256-Foundation/emberone00-pcb/(threads)

Thread 4 (2024-11-18):

Release validated Ember One design

econoalchemist, 2024-11-18:
# Ember One

## Scope:
One Project Manager position and up to two engineer positions to fulfill the mission of The 256 Foundation, “ Make Bitcoin mining free and open”. This grant proposal aims to secure funding for:
- A project manager to oversee and ensure mission adherence, timeliness, and execution.
Up to two engineers to develop the Ember One hashboard.
-  Ember One technical details: a modular ~100W 2-4 Terahash open-source Bitcoin miner hashboard built with the Bitmain S19 J-Pro series ASIC chips including hardware component selection, PCB design, and thermal design.
- Supporting documentation with hashboard interface specification.
- This project is fully open-source GPL licensed.
- Excluded from this proposal are the firmware architecture & implementation, enclosure design, manufacturing support, sales, distribution, marketing, and customer technical support.

In summary, the Ember One grant delivers an open-source, discrete, and customizable ~100 Watt Bitcoin miner hashboard in six months with a project manager and up to two engineers. This project will be a springboard for a complete mining system built with ASIC chips from other manufacturers. The open design makes integrating it in a variety of ways possible. The small but mighty platform provides the essential tools for broad open development. Remaining anonymous while using Bitcoin's public blockchain is a crucial aspect to ensuring the potential for financial freedom; and Bitcoin mining is arguably the best way to acquire bitcoin for these ends. Not only does the Ember One equip users with a powerful tool for financial freedom but it also takes direct aim at altering the centralized and closed-source trajectory that the Bitcoin mining ecosystem has taken.

## Deliverables:
The deliverables from this grant are the successful execution of the project more so than tangible goods. Successful execution of this grant project means the delivery of a validated design for a modular ~100W hashboard is produced within the allotted timeline and for the available budget, resulting in an open-source project that aligns with The 256 Foundation mission and benefits the public at large.

## Timeline:
The timeline for this grant proposal is six months with the opportunity to extend the grant at the conclusion of each six month period, pending negotiations. This grant officially started November 1, 2024 and will conclude on April 30, 2025.

## Materials:
Materials for this project’s prototype are included in the budget. Potential materials for the project may include but are not limited to ASIC chips, miscellaneous components, and various tools or software.

## Team Members:
This proposal is for one project manager and up to two engineers.

## Budget:
For security reasons, exact dollar amounts are kept confidential. This project budget covers fair-market compensation for one project manager as well as the materials, travel expenses, and living expenses for up to two engineers for six months. Funds are disbursed monthly in six equal amounts. Within 30-days prior to the expiration of this proposal, a renewal opportunity will open and be subject to review and negotiation.

econoalchemist, 2025-06-21:
See the v3 release from April 30, 2025 for the initial validated design.

https://github.com/256-Foundation/emberone00-pcb/tree/v3

Closed 2025-06-21.

Thread 15 (2025-02-05):

Double Check BOM on U10

skot, 2025-02-05:
Somehow I ended up with the wrong part for U10, the 3.3V LDO. Double check the BOM

skot, 2025-02-25:
BOM is correct. this was prolly a late change.

Closed 2025-02-25.

Thread 16 (2025-02-22):

Last chip in the chain needs a 1k pull-up on RI

skot, 2025-02-22:
The last chip in the serial chain needs a 1k pull-up on the "response input" RI pin.

skot, 2025-04-09:
fixed in v3

Closed 2025-04-09.

Thread 17 (2025-02-24):

PIN_MODE on ASIC columns 0 & 2 is set wrong.

skot, 2025-02-24:
ASICs U45-U47 (column 0) and U63-U65 (column 2) have the PIN_MODE pin set incorrectly. Where it is floating it should be GND and vice-versa

skot, 2025-04-09:
fixed in v3

Closed 2025-04-09.

Thread 18 (2025-02-25):

Double check BM1362 footprint spacing

skot, 2025-02-25:
It seems like the BM1362 pins extend a little too close to the center power pads. Double check the spacing with the S19j Pro hashboard footprint

skot, 2025-03-11:
In 67fa04b I changed the spacing between the pads and the pins and moved the VDD pad up a little bit.

I think there still might be an issue with the pin pitch.

econoalchemist, 2025-03-12:
I see three potential variables that could complicate efforts to ensure the spacing is correct:

1) The pin spacing from chip to chip might vary. Could be worth measuring two or more chips to test this theory.

2) The PCB manufacturer may have a loose tolerance that misplaced some of the pin pads. Could be worth measuring the PCB itself to ensure it matches the requested design measurements.

3) The required precision might be beyond the resolution capabilities of the imaging equipment. Could be helpful to sharpen the image in GIMP or Photoshop or an online tool prior to feeding the image to the measuring software to mitigate aliasing.

skot, 2025-04-09:
fixed in v3

Closed 2025-04-09.

Thread 19 (2025-02-26):

noise on ASIC serial line with core voltage on

skot, 2025-02-26:
When monitoring the ASIC serial port via the RP2040 I saw some erroneous 0xFF bytes come through. This is prolly noise on the serial lines. Not sure of the source yet.

econoalchemist, 2025-03-12:
Curious what the noise level is on the S9? Would it be worth checking as a baseline acceptable target to aim for?

skot, 2025-03-13:
For comparison, after the tweaks mentioned in #23 #24 #25 and #26 I was able to get the emberOne at 3.6V, 40W to 60mV p-p. This noise is 1.66% of the output. (note the different vertical scale)

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

Thread 20 (2025-02-26):

Can't adjust LM25119 output voltage

skot, 2025-02-26:
the LM25119 is adjusted with the DS4432U. At the moment I haven't been able to adjust from the default 3.6V output. This is _prolly_ just a problem with my test script 🤞

skot, 2025-02-28:
This was just a test firmware bug on my end. Its working fine. especially with #21

Thread 21 (2025-02-28):

change full scale range resistor on DS4432U

skot, 2025-02-28:
The S19j Pro comes with the APW121215 PSU which can output a range of 12-15V. with 42 voltage domains per hashboard, this means that each chip will receive from 285mV to 357mV.

We need to adjust the full scale range on the DS4432U in order to better cover this core voltage range.

Setting the R_FS resistor, aka R11 on the emberOne to 39kOhms, this give us an adjustable range of 239mV to 360mV for each of the 12 ASICs.

skot, 2025-04-09:
fixed in v3

Closed 2025-04-09.

Thread 22 (2025-03-05):

NRST signals should have pulldowns when crossing voltage domains

skot, 2025-03-05:
Looking at the S19j Pro hashboard it looks like every NRST line has a 2k pulldown. I did not see any of the 33ohm series resistors that the other signals have.

skot, 2025-03-05:
on further inspection it looks like NRST signals _that cross voltage domains_ do have 33ohm series resistors.

furthermore, the NRST pulldown is connected to GND on the **NRSTO** side.

Closed 2025-04-09.

Thread 23 (2025-03-08):

reorient the "right" side inductor for smaller SW2 loop area

skot, 2025-03-08:
Prolly a 90º CW would do it. Maybe there is a way to put both inductors on the left side of the PCB? 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

skot, 2025-04-09:
fixed in v3

Closed 2025-04-09.

Thread 24 (2025-03-08):

Add pads for HO and LO series resistors

skot, 2025-03-08:
this can be tuned to reduce spikes in the output from fast switching

skot, 2025-04-09:
fixed in v3

Closed 2025-04-09.

Thread 25 (2025-03-08):

Add pads for snubbers

skot, 2025-03-08:
Add pads for snubbers on both SW loops to GND. this can be tuned to reduce spikes in the output

skot, 2025-04-09:
fixed in v3

Closed 2025-04-09.

Thread 26 (2025-03-08):

Add pads for ceramic output caps

skot, 2025-03-08:
Just a couple 0805 pads for 0.1uF and 1uF output filter caps. Maybe add series resistor options?

Thread 27 (2025-04-14):

snubber resistors R27, R28 should be 1W

skot, 2025-04-14:
they do dissipate some power. LM25119 reccommends 2512 package

skot, 2025-04-22:
Also, importantly, the snubber should be much closer to the low side mosfet, with short traces as there will be some current flowing

Thread 28 (2025-04-18):

add TVS protection diodes on voltage regulator VIN and VOUT

skot, 2025-04-18:
- on VIN i'll try [SMCJ28A](https://www.digikey.com/en/products/detail/taiwan-semiconductor-corporation/SMCJ28A/1051842)
- on VOUT i'll try [SMBJP6KE6.8A-TP](https://www.digikey.com/en/products/detail/mcc-micro-commercial-components/SMBJP6KE6-8A-TP/2345608)

air wire them first, if that seems reasonable add them to the board

Thread 29 (2025-04-18):

Last ASIC in chain doesn't respond with VDD @ 3.6V

skot, 2025-04-18:
With VDD set to 3.6V it seems that the last asic in the chain doesn't respond to the ping command. This may be related to #19

skot, 2025-04-22:
this doesn't seem to be happening anymore. It's possible this was fixed by #22 or #16 ? Still investigating.

Thread 30 (2025-04-19):

add pads for high side mosfet snubber resistors

skot, 2025-04-19:
Place an RC snubber across each high-side MOSFET (drain-to-source): try 100 pF + 10 Ω

skot, 2025-04-21:
Interesting. The [LM25119 Datasheet](https://www.ti.com/lit/ds/symlink/lm25119.pdf) section says to put the snubber across the **low** side mosfet. The EVM has the values set to 1000pF and 5.1 Ohm. See #27

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

skot, 2025-04-21:
EVM snubber capacitor is `C2012C0G2A102J`

GitBobCat, 2025-04-27:
If you are dealing with ringing then https://e2e.ti.com/cfs-file/__key/communityserver-discussions-components-files/196/slup100.pdf

Theory says you have Cpar, the parasitic at the node, and Csnb, the capacitor to snub the ringing. Csnb = 3*Cpar. You select the damping resistor, Rdmp, to be the resonant impedance. Rdmp=SQRT(L/Cpar).

Your L will be the buck inductor, 6u8 in your example schematic. Your Cpar might be guessed at from the Mosfet datasheets. You get a graph of Coss, Ciss and Crss. I forget the sums to hit the value you want and it's a bit wet finger based on Vds.

Alternatively you can scope it with no added components to get an Fr1 for the resonant frequency and then add a known capacitor to get an Fr2 for the shifted, lower, frequency. Then solve Fr1=1/2.Pi.SQRT(LCpar) and Fr2=1/2.Pi.SQRT(L(Cpar+Cadd) for Cpar and select Csnb=3*Cpar etc.

HTH

skot, 2025-04-27:
Ringing seems to be minimal... the problem is mostly spikes at the switching edges.

GitBobCat, 2025-04-27:
Grumble. Yes, I have seen that one mentioned on the data sheet. I'm uncertain as to why it should be there and if it is a real issue beyond looking bad. Being buck then under load the inductor is always going to reset through the lower mosfet, initially its body source diode. During regen, load dump, it will initially free-wheel back through the upper Mosfet body source diode. Assuming your input supply is stiff also theoretically not a problem.... unless the layout is sloppy. Decouple tight to the upper device. Mosfets, if you buy the right ones, are also rated for repetitive avalanche as long as you do not exceed the transient thermal impedance curves. Whatever way spikes are unclamped inductive energy seeking a way out and, waving a wet finger, with a 20A supply and a 5R1 snubber resistor you'll get a 102 volt spike unless something else catches it so that particular snubber is not really doing anything to those spikes. Measure tight to the Drain Source connection and use the springy ground needle thing on the probe tip collar to see if they are really there.

Thread 33 (2025-04-24):

Check USB power

skot, 2025-04-24:
Unconfigured USB devices should not draw over 100mA. as per [USB Wikipedia](https://en.wikipedia.org/wiki/USB_hardware#Allowable_current_draw). Once configured, "High-power devices" may draw up to 500mA.

500mA should be plenty. Not sure about 100mA. Either way, I should characterize how much power is needed over USB.

skot, 2025-04-25:
While mining i'm seeing 50-60mA, depending on how the LED is set.

Thread 34 (2025-04-24):

measure at least the first ASIC temp diodes

skot, 2025-04-24:
BM1362 ASICs all have internal temp diodes. It's a little tricky measuring these with all the floating grounds we have. But we could at least measure the internal temp of the first ASIC, which is global GND referenced.

Prolly switch one of the TMP1075 air temp sensors out for a EMC2101.

Thread 36 (2025-04-24):

Add a fan connector?

skot, 2025-04-24:
The idea is to add some sort of fan connector on the emberOne to better facilitate single device hacking. This is a little tricky since most fans want 12V, and we don't have a fixed 12V available on the EmberOne. (VIN is 12-24V).

- We could just add a fan connector on VIN and say only use it if your fan is compatible with your input voltage.
     - This could lead to some sadness if you have VIN too high and burn out the fan
- We could add a proper fan controller (like say the EMC2101 potentially for #34) and have it connected to MCU I2C. Still have the VIN problem from above.
     - Same problem as above
- We could add a 12V voltage regulator and do either of the options from above.
     - Now _everyone_ has to pay for a 12V voltage regulator, even if they are using a separate system fan, or no fans at all (immersion, hydro, etc)

Thread 37 (2025-04-24):

Add reverse polarity protection?

skot, 2025-04-24:
Right now the emberOne is unprotected from reverse polarity power connections. I kinda think that's fine, but it would be nice to not destory your computer too.. maybe we need reverse polarity protestion on the USB port? for the upstream host?

zbomz, 2025-05-02:
Based on my experience with Loki plebs tinkering with Loki rigs and seeing about half of them blow up at least one hash board while tinkering, I'm a huge proponent of adding reverse polarity protection.

As discussed in the "Ember One Schematic Review Video," reverse polarity protection could be added to either the USB port to at least protect the host PC or to the hash board's main power terminals. Adding reverse polarity protection to the USB port presents a challenge given that both power (VBUS) and data are connected. VBUS can be protected fairly easily with a simple shottky diode given the sub 500mA current draw, but protecting the high speed data lines is harder. It would likely require expensive isolation components/circuitry, and after all that, the hash board would still be vulnerable.

On the other hand, adding reverse protection polarity to the hash board's main power terminals should protect both the hash board and the host PC, and robust reverse polarity protection can be achieved relatively simply and cheap.

The design shown below implements an "ideal diode" circuit using an N-type MOSFET on the high side rail and a dedicated charge pump driver. This design offers reverse polarity protection while limiting the forward voltage drop to no more than 35mV at 10 amps. Components were selected specifically to support the max 24V input voltage. The component cost at 1K quantities is about $1.10.

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

skot, 2025-06-09:
U1: AP74700QW6-7 [DK: [31-AP74700QW6-7CT-ND](https://www.digikey.com/en/products/detail/diodes-incorporated/ap74700qw6-7/16680522)]
Q1: NVMFS5C645NL [DK: [488-NVMFS5C645NLAFT1GCT-ND](https://www.digikey.com/en/products/detail/onsemi/NVMFS5C645NLAFT1G/7220982)]
C_CP: CC0805KRX7R9BB104
CIN: GRM155R71H223KA12J
COUT: GRM21BR61H745ME51L
TVS: SMBJ30CA [DK: [SMBJ30CALFCT-ND](https://www.digikey.com/en/products/detail/littelfuse-inc/SMBJ30CA/286005)]

Thread 39 (2025-05-01):

Add USB-C Power Delivery sink support

mailinger-mate, 2025-05-01:
The EmberOne/00 currently accepts 12–24 V via a barrel jack but cannot negotiate USB-C Power Delivery. Adding PD sink support will allow the board to draw up to 20 V @ 5 A (100 W) directly from USB-C chargers, improving flexibility for field power.

**Objectives**
- Negotiate and accept 20 V @ 5 A (100 W) over USB-C PD 3.0
- Feed negotiated VBUS directly into the existing 12–24 V input net
- Minimize impact on the current power-train (no additional DC–DC stages or firmware changes)

**Proposed Changes**
1. **Add a Type-C receptacle** footprint rated for 5 A, if not already present.
2. **Add STUSB4500 PD or other sink controller** in “auto-run” mode to negotiate 5 A@20 V on the CC lines.
3. **Include supporting passives**: CC pull-resistors, VBUS discharge MOSFET (optional), TVS diode for surge protection.
4. **Route negotiated VBUS** from the PD controller into the VIN net (12–24 V domain).
5. **Update PCB layout & DRC** to meet USB-C/C-EPR creepage/clearance and 5 A copper width requirements.
6. **Optional**: add a simple power-path mux (diode or ideal-diode scheme) if barrel-jack coexistence is needed.
7. **Revise BOM** to include:
   - STUSB4500 IC
   - USB-C 5 A receptacle
   - CC resistors, MOSFETs/TVS, small passives

**Rough BOM cost**
| Component                           | Unit price             |
|----------------------------|------------------|
| STUSB4500 PD sink IC        |        US $ 2.11      |
| USB-C 5 A receptacle          |        US $ 0.92     |
| Passives & TVS diode           |       US $ 0.50*    |
| **Total incremental BOM**  | **≈ US $ 3.50**  |

**Acceptance Criteria**
- Board powers up and negotiates 20 V @ 5 A from a compliant PD charger
- No changes required to the rest of the power-train or firmware
- Layout passes clearance checks for 20 V and high-current USB-C
- BOM updated and documentation (silkscreen/schematic) reflects new components

**References**
- [STUSB4500 datasheet & application notes](https://www.mouser.com/c/semiconductors/interface-ics/usb-interface-ic/?series=STUSB4500)
- [USB Type C Connectors USB Connectors - Mouser Electronics](https://www.mouser.com/c/connectors/usb-connectors/?product=USB+Type+C+Connectors)
- [USB-IF Type-C Spec (Release 2.0, Aug 2019)](https://www.usb.org/sites/default/files/USB%20Type-C%20Spec%20R2.0%20-%20August%202019.pdf) See Section 3.2.1, “Reference Footprint for a USB Type-C Full-Featured Receptacle” (Figures 3-8 through 3-10) for recommended land patterns and mechanical dimensions.

skot, 2025-05-01:
USB-C power would be cool, but I think less practical for people who want to use several emberOne in a system. The most practical setup there would be a power bus bar, connecting several in parallel. That gets harder with USB-C.

USB-C power would be great for single emberOne setups. The thing I can't wrap my head around (same problem on Bitaxe); we use USB-C for data. Do we add separate USB-C ports for power and data? That gets confusing. There are some options for USB-C PD _and_ data but afaik this requires the user to buy an expensive adapter to use both. Maybe you can ask ChatGPT about that 😉

mailinger-mate, 2025-05-02:
Thank you @skot, I didn't mean to be impersonal, im just lame in this subject and need help from ChatGPT.

How about using the USB-C for data only if the PD connection cannot be negotiated for the 100W needed?

A. With the barrel-jack support that would require more parts for OR-ing with diodes and for protection
B. Removing the barrel-jack: fewer parts, no OR-ing circuitry, simpler layout, and a single negotiated PD voltage to design around. Just keep the Type-C footprint, wire CC1/CC2 into your PD sink IC, beef up the VBUS copper for 5 A.

What do you think?

skot, 2025-06-09:
In an effort to keep things simple, I am not going to use USB-C PD for emberOne at this time.

Thread 40 (2025-05-01):

Temperature / Power readings fail sometimes

skot, 2025-05-01:
I _think_ this is a software issue, but I'd like to be sure. failed temp / power readings cause overtemp/current shutdown and interrupt mining.

I have been able to reproduce this by reading temp/power at 0.1s intervals. every so often the INA260 current comes back as 0xFF

```
Voltage: 0.00 V
ctrl rx: [02 00 BB 00 00]
Current: 0.00 A
ctrl rx: [02 00 DD 00 00]
Power: 0.00 W
ctrl rx: [02 00 AA 1A 20]
ctrl rx: [02 00 BB 19 B0]
Temp: 26ºC, 25ºC
LED Color: Magenta
ctrl rx: [02 00 CC 00 01]

Voltage: 0.00 V
ctrl rx: [02 00 BB 00 00]
Current: 0.00 A
ctrl rx: [02 00 DD 00 00]
Power: 0.00 W
ctrl rx: [02 00 AA 1A 20]
ctrl rx: [02 00 BB 19 B0]
Temp: 26ºC, 25ºC
LED Color: Green
ctrl rx: [02 00 CC 00 01]

Voltage: 0.00 V
ctrl rx: [02 00 BB FF FF] <-- oops
Current: 81.92 A          <-- oops
ctrl rx: [02 00 DD 00 00]
Power: 0.00 W
ctrl rx: [02 00 AA 1A 20]
ctrl rx: [02 00 BB 19 B0]
Temp: 26ºC, 25ºC
LED Color: Magenta
ctrl rx: [02 00 CC 00 02]
```

skot, 2025-05-01:
This doesn't seem to be a ember one-usbserial-fw issue.. the ID field is still coming back correct. I bet the INA260 just isn't ready.
