256-Foundation/emberone00-pcb/(commit log)

2025-07-13 Update emberone BOM.csv
    Added [DigiKey P/N](https://www.digikey.com/en/products/detail/shenzhen-sctf-electronics/SX3M25-000E20F30THN/25573861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) for line #56, reference #U5.
    [emberone BOM.csv]
2025-07-14 Revert "Update emberone BOM.csv"
    This reverts commit cc2f20a31db7e8d8b9c498accbf56818088fe10f.
    [emberone BOM.csv]
2025-09-11 remover old gerbers, bom, ibom. Changed C29 to 1000pF for #47
    [emberone BOM.csv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]
2025-09-11 Update INA260 (U3) to TI reel part number for #46
    [emberone.kicad_pcb, power.kicad_sch]
2025-09-11 fixup fiducials for #49
    [emberone.kicad_pcb, emberone.kicad_sch]
2025-09-11 remove all power pads, replace with planes, including on back layer. regenerate BOM
    [asic-3up-0.kicad_sch, asic-3up-1.kicad_sch, asic-3up-2.kicad_sch, asic-3up-3.kicad_sch, data.kicad_sch, emberone BOM.csv, emberone.kicad_pcb]
2025-09-11 added topside data test pads. cleaned up power pads some more.
    [asic-3up-0.kicad_sch, asic-3up-1.kicad_sch, asic-3up-2.kicad_sch, asic-3up-3.kicad_sch, emberone.kicad_pcb]
2025-09-11 bumped version to v4.1 in schematic and PCB silkscreen
    [asic-3up-0.kicad_sch, asic-3up-1.kicad_sch, asic-3up-2.kicad_sch, asic-3up-3.kicad_sch, data.kicad_sch, emberone.kicad_pcb, emberone.kicad_sch, power.kicad_sch]
2025-09-11 change input voltage silkscreen for #50
    [emberone.kicad_pcb]
2025-09-11 generated (and checked) gerbers. generated pos file. generated iBOM
    [emberone-B_Cu.gbr, emberone-B_Mask.gbr, emberone-B_Paste.gbr, emberone-B_Silkscreen.gbr, emberone-Edge_Cuts.gbr, emberone-F_Cu.gbr, emberone-F_Mask.gbr, emberone-F_Paste.gbr]
