256-Foundation/emberone00-pcb/emberone.kicad_pcb

## KiCad design emberone.kicad_pcb (2025-09-11)

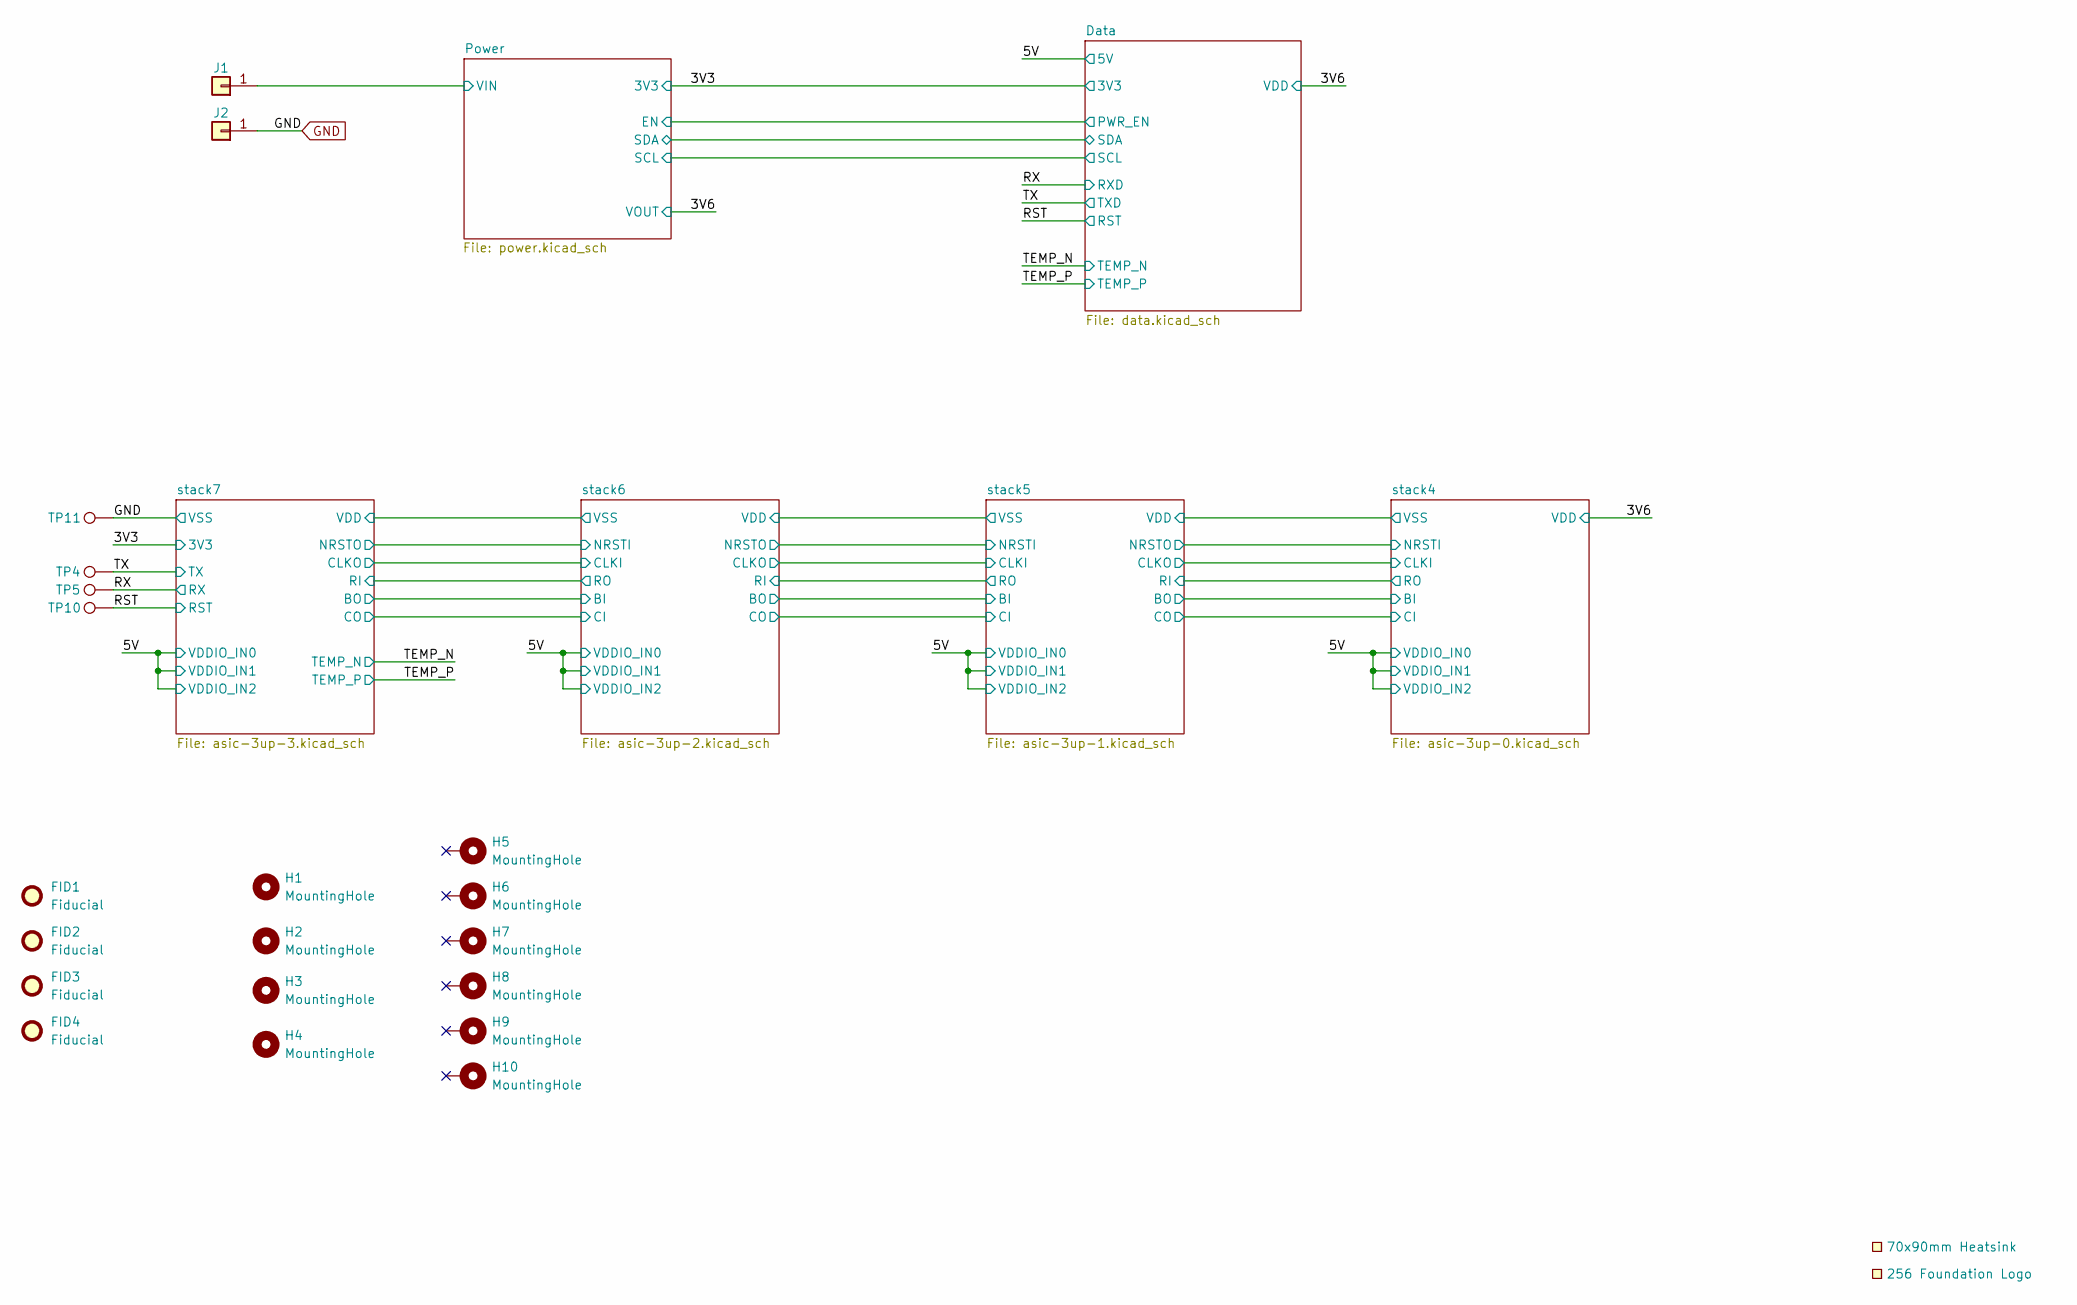
[picture p1: schematic emberone.kicad_sch, emberOne/00]

Parts:
EXTRA1: 70x90mm Heatsink; 70x90mm_heatsink
FID1, FID2, FID3, FID4: Fiducial; Fiducial_1mm_Mask2mm
H1, H2, H3, H4: MountingHole; MountingHole_3.5mm
H5, H6, H7, H8, H9, H10: MountingHole; MountingHole_3.2mm_M3_Pad
J1, J2: Screw Terminal; 7790-RA-screw-terminal; PARTNO 7790
LOGO1: 256 Foundation Logo; 256foundation_logo
TP4, TP5, TP10, TP11: TestPoint; TestPoint_Pad_D1.0mm

Connections:
/Power/VIN: J1.1; also elsewhere on the board
/RST: TP10.1; also elsewhere on the board
/RX: TP5.1; also elsewhere on the board
/TX: TP4.1; also elsewhere on the board
GND: J2.1, TP11.1; also elsewhere on the board

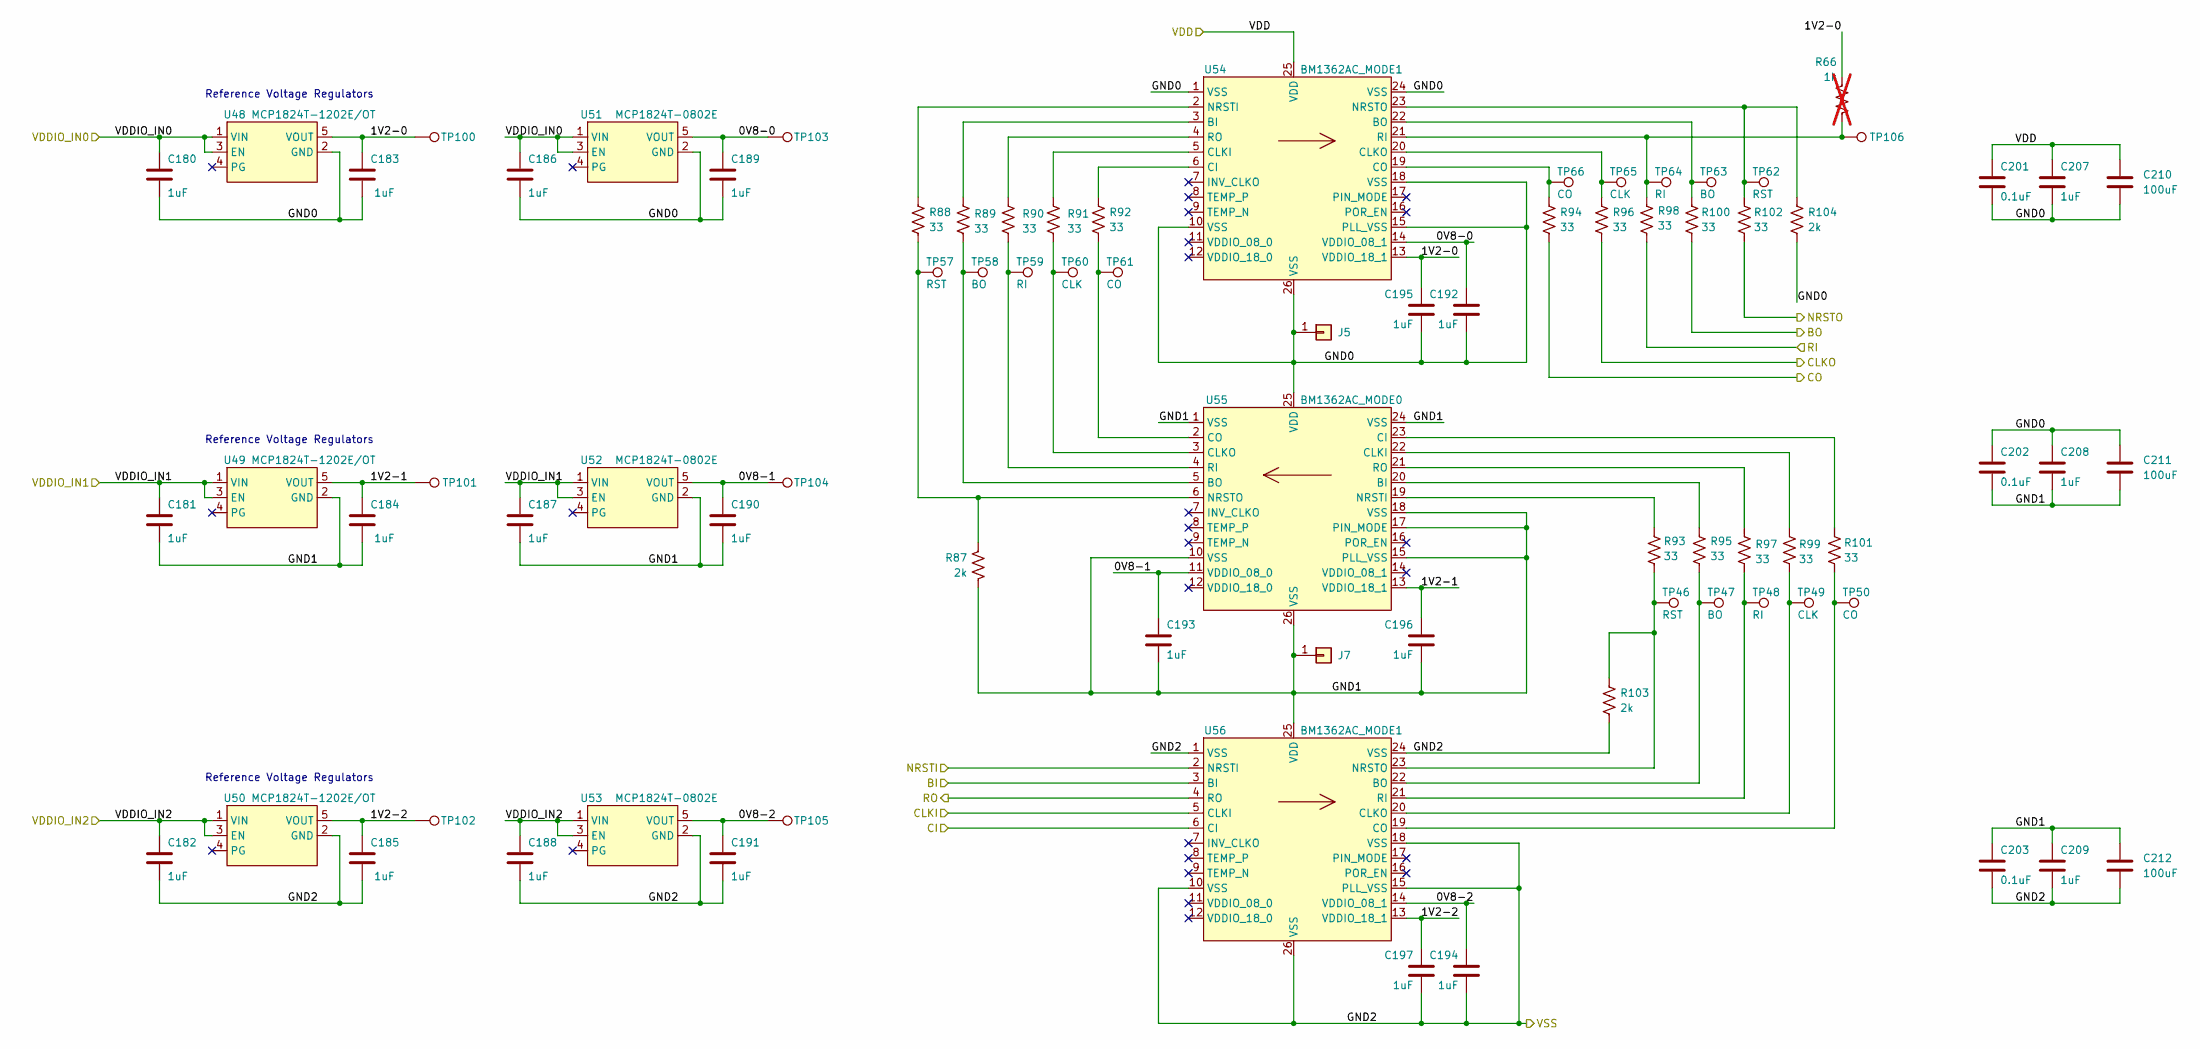
[picture p2: schematic asic-3up-1.kicad_sch, emberOne/00]

Parts:
C180, C181, C182, C183, C184, C185, C186, C187, C188, C189, C190, C191, C192, C193, C194, C195, C196, C197, C207, C208, C209: 1uF; C_0402_1005Metric; PARTNO EMK105BJ105MV-F; LCSC C52923
C201, C202, C203: 0.1uF; C_0402_1005Metric; PARTNO KGM05AR71C104KH; LCSC C307331
C210, C211, C212: 100uF; C_1206_3216Metric; PARTNO CL31A107MQHNNNE; LCSC C15008
J5, J7: Conn_01x01; 5x9_powertab
R66: 1k; R_0402_1005Metric; not fitted
R87, R103, R104: 2k; R_0402_1005Metric; PARTNO RC0402FR-072KL; LCSC C60488
R88, R89, R90, R91, R92, R93, R94, R95, R96, R97, R98, R99, R100, R101, R102: 33; R_0402_1005Metric; PARTNO RC0402FR-0733RL; LCSC C25105
TP46, TP57, TP62: RST; TestPoint_Pad_1.0x0.4mm
TP47, TP58, TP63: BO; TestPoint_Pad_1.0x0.4mm
TP48, TP59, TP64: RI; TestPoint_Pad_1.0x0.4mm
TP49, TP60, TP65: CLK; TestPoint_Pad_1.0x0.4mm
TP50, TP61, TP66: CO; TestPoint_Pad_1.0x0.4mm
TP100, TP101, TP102, TP103, TP104, TP105, TP106: TestPoint; TestPoint_Pad_D1.0mm
U48, U49, U50: MCP1824T-1202E/OT; SOT-23-5; PARTNO MCP1824T-1202E/OT
U51, U52, U53: MCP1824T-0802E; SOT-23-5; PARTNO MCP1824T-0802E/OT
U54, U56: BM1362AC_MODE1; BM1362AC
U55: BM1362AC_MODE0; BM1362AC

Connections:
/5V: C180.1, C181.1, C182.1, C186.1, C187.1, C188.1, U48.1 (VIN), U48.3 (EN), U49.1 (VIN), U49.3 (EN), U50.1 (VIN), U50.3 (EN), U51.1 (VIN), U51.3 (EN), U52.1 (VIN), U52.3 (EN), U53.1 (VIN), U53.3 (EN); also elsewhere on the board
/stack4/BI: R100.2; also elsewhere on the board
/stack4/CI: R94.2; also elsewhere on the board
/stack4/CLKI: R96.2; also elsewhere on the board
/stack4/GND2: C201.1, C207.1, C210.1, U54.25 (VDD); also elsewhere on the board
/stack4/NRSTI: R102.2; also elsewhere on the board
/stack4/RO: R98.2; also elsewhere on the board
/stack5/0V8-0: C189.1, C192.1, TP103.1, U51.5 (VOUT), U54.14 (VDDIO_08_1)
/stack5/0V8-1: C190.1, C193.1, TP104.1, U52.5 (VOUT), U55.11 (VDDIO_08_0)
/stack5/0V8-2: C191.1, C194.1, TP105.1, U53.5 (VOUT), U56.14 (VDDIO_08_1)
/stack5/1V2-0: C183.1, C195.1, R66.1, TP100.1, U48.5 (VOUT), U54.13 (VDDIO_18_1)
/stack5/1V2-1: C184.1, C196.1, TP101.1, U49.5 (VOUT), U55.13 (VDDIO_18_1)
/stack5/1V2-2: C185.1, C197.1, TP102.1, U50.5 (VOUT), U56.13 (VDDIO_18_1)
/stack5/BI: U56.3 (BI); also elsewhere on the board
/stack5/CI: U56.6 (CI); also elsewhere on the board
/stack5/CLKI: U56.5 (CLKI); also elsewhere on the board
/stack5/GND0: C180.2, C183.2, C186.2, C189.2, C192.2, C195.2, C201.2, C202.1, C207.2, C208.1, C210.2, C211.1, J5.1, R104.2, U48.2 (GND), U51.2 (GND), U54.1 (VSS), U54.10 (VSS), U54.15 (PLL_VSS), U54.18 (VSS), U54.24 (VSS), U54.26 (VSS), U55.25 (VDD)
/stack5/GND1: C181.2, C184.2, C187.2, C190.2, C193.2, C196.2, C202.2, C203.1, C208.2, C209.1, C211.2, C212.1, J7.1, R87.2, U49.2 (GND), U52.2 (GND), U55.1 (VSS), U55.10 (VSS), U55.15 (PLL_VSS), U55.17 (PIN_MODE), U55.18 (VSS), U55.24 (VSS), U55.26 (VSS), U56.25 (VDD)
/stack5/GND2: C182.2, C185.2, C188.2, C191.2, C194.2, C197.2, C203.2, C209.2, C212.2, R103.2, U50.2 (GND), U53.2 (GND), U56.1 (VSS), U56.10 (VSS), U56.15 (PLL_VSS), U56.18 (VSS), U56.24 (VSS), U56.26 (VSS); also elsewhere on the board
/stack5/NRSTI: U56.2 (NRSTI); also elsewhere on the board
/stack5/RO: U56.4 (RO); also elsewhere on the board
unnamed: R89.1, U54.3 (BI)
unnamed: R100.1, TP63.1, U54.22 (BO)
unnamed: R92.1, U54.6 (CI)
unnamed: R91.1, U54.5 (CLKI)
unnamed: R96.1, TP65.1, U54.20 (CLKO)
unnamed: R94.1, TP66.1, U54.19 (CO)
unnamed: R88.1, U54.2 (NRSTI)
unnamed: R102.1, R104.1, TP62.1, U54.23 (NRSTO)
unnamed: R66.2, R98.1, TP64.1, TP106.1, U54.21 (RI)
unnamed: R90.1, U54.4 (RO)
unnamed: R95.1, U55.20 (BI)
unnamed: R89.2, TP58.1, U55.5 (BO)
unnamed: R101.1, U55.23 (CI)
unnamed: R99.1, U55.22 (CLKI)
unnamed: R91.2, TP60.1, U55.3 (CLKO)
unnamed: R92.2, TP61.1, U55.2 (CO)
unnamed: R93.1, U55.19 (NRSTI)
unnamed: R87.1, R88.2, TP57.1, U55.6 (NRSTO)
unnamed: R90.2, TP59.1, U55.4 (RI)
unnamed: R97.1, U55.21 (RO)
unnamed: R95.2, TP47.1, U56.22 (BO)
unnamed: R99.2, TP49.1, U56.20 (CLKO)
unnamed: R101.2, TP50.1, U56.19 (CO)
unnamed: R93.2, R103.1, TP46.1, U56.23 (NRSTO)
unnamed: R97.2, TP48.1, U56.21 (RI)

Notes on the sheet:
Reference Voltage Regulators

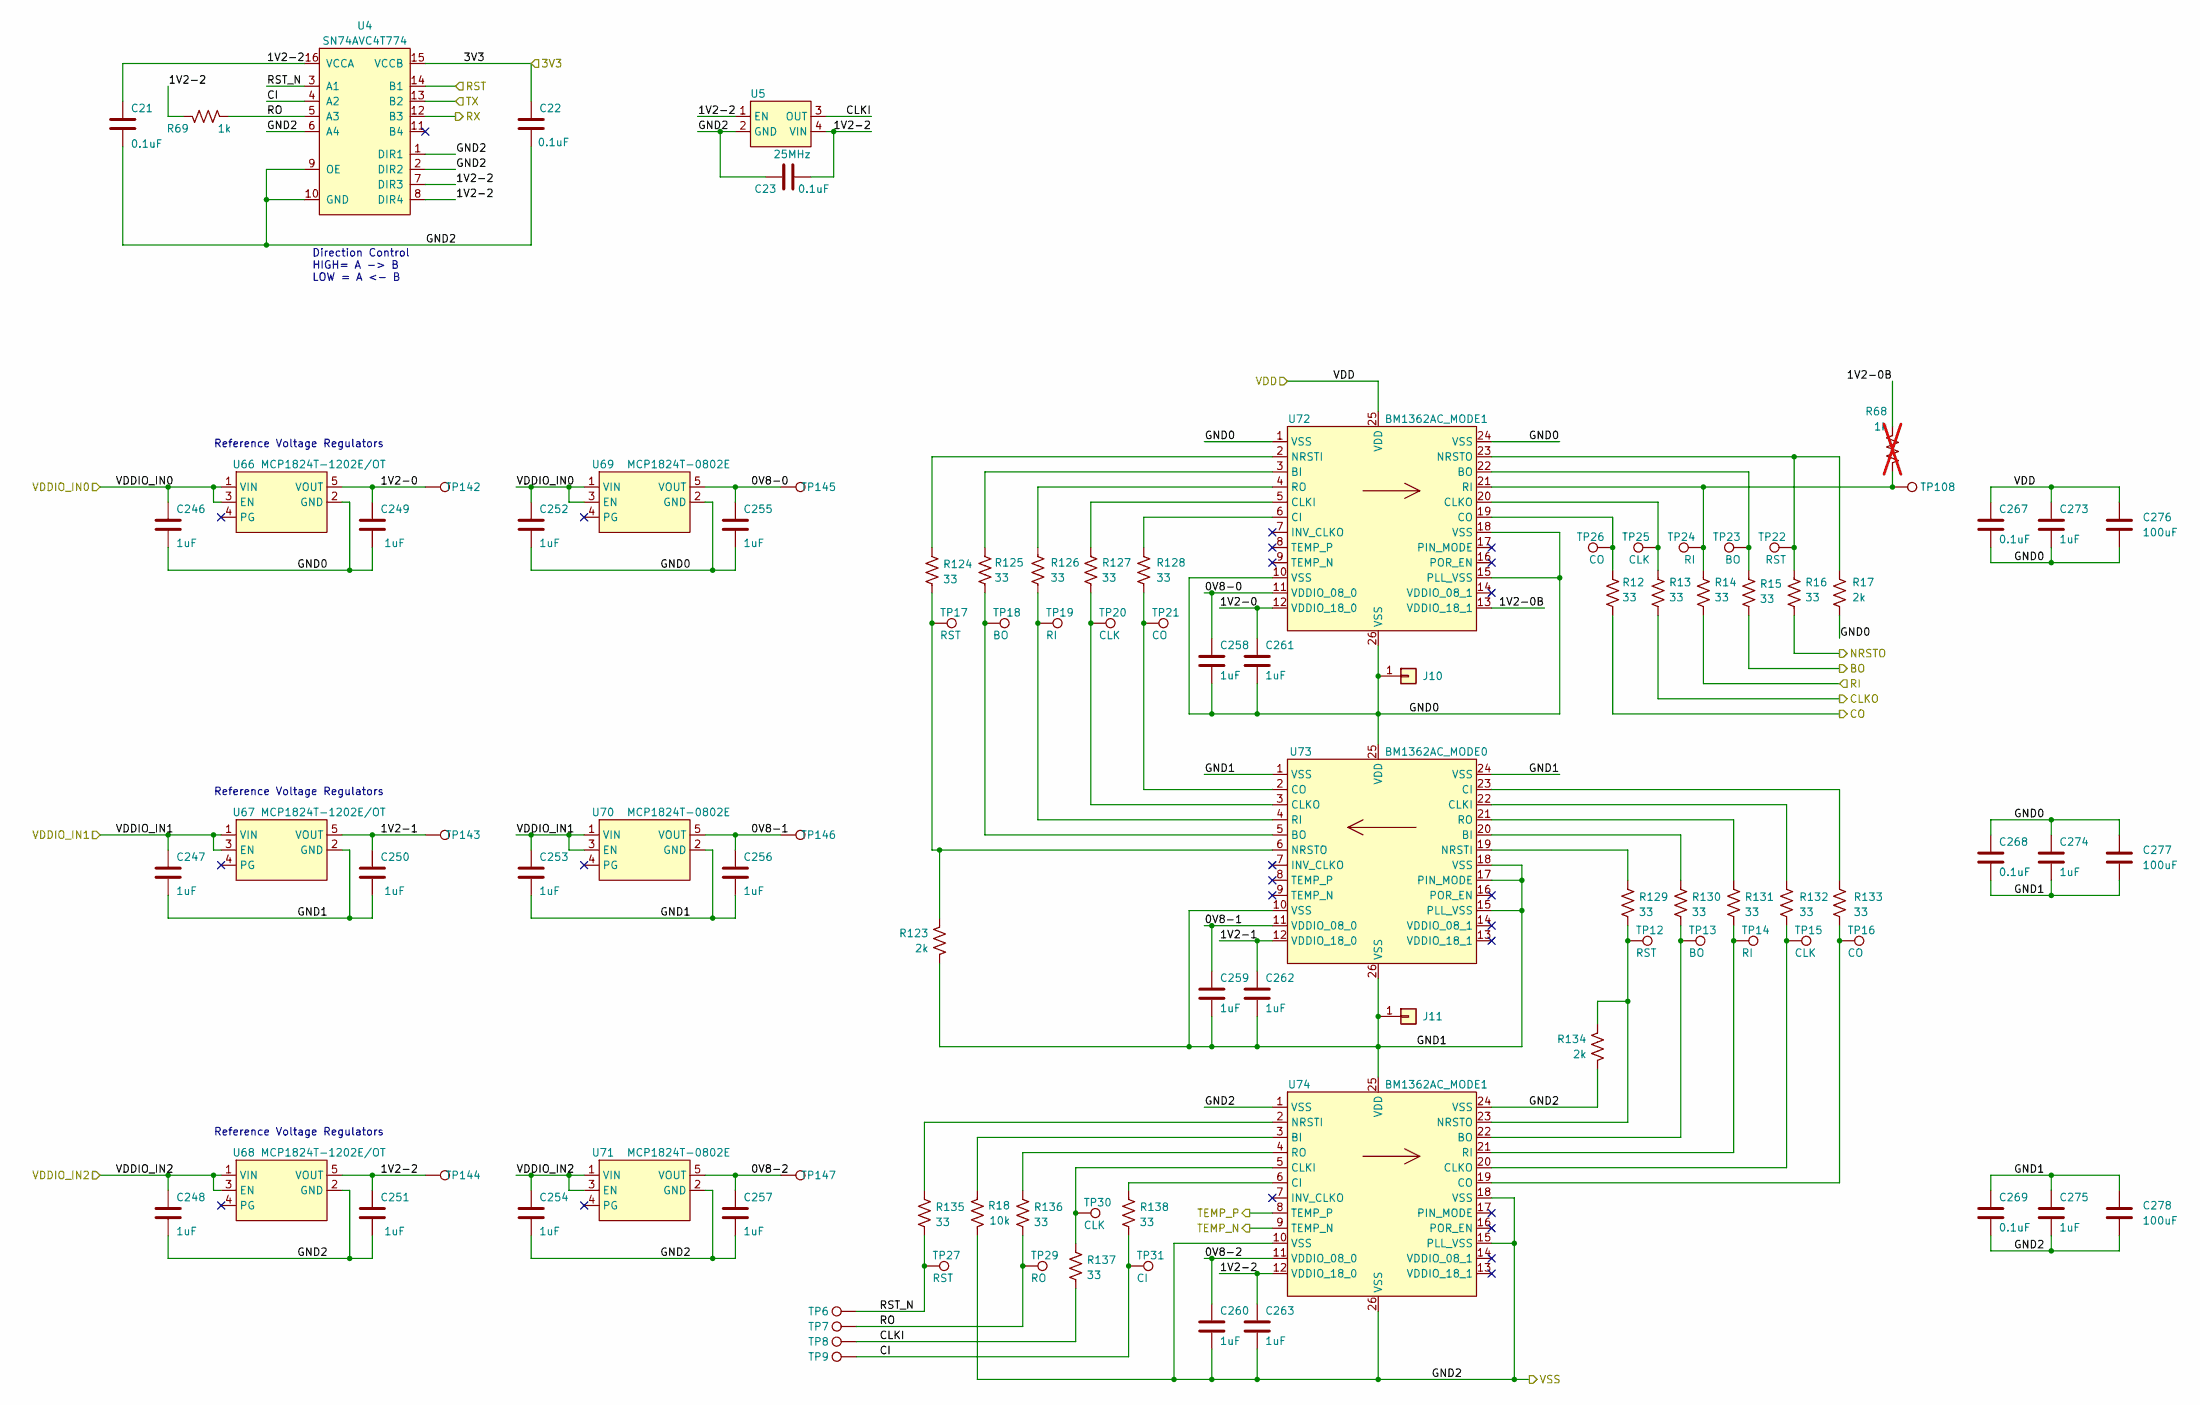
[picture p3: schematic asic-3up-3.kicad_sch, emberOne/00]

Parts:
C21, C22, C23, C267, C268, C269: 0.1uF; C_0402_1005Metric; PARTNO KGM05AR71C104KH; LCSC C307331
C246, C247, C248, C249, C250, C251, C252, C253, C254, C255, C256, C257, C258, C259, C260, C261, C262, C263, C273, C274, C275: 1uF; C_0402_1005Metric; PARTNO EMK105BJ105MV-F; LCSC C52923
C276, C277, C278: 100uF; C_1206_3216Metric; PARTNO CL31A107MQHNNNE; LCSC C15008
J10, J11: Conn_01x01; 5x9_powertab
R12, R13, R14, R15, R16, R124, R125, R126, R127, R128, R129, R130, R131, R132, R133, R135, R136, R137, R138: 33; R_0402_1005Metric; PARTNO RC0402FR-0733RL; LCSC C25105
R17, R123, R134: 2k; R_0402_1005Metric; PARTNO RC0402FR-072KL; LCSC C60488
R18: 10k; R_0402_1005Metric; PARTNO RC0402FR-0710KL; LCSC C25744
R68: 1k; R_0402_1005Metric; not fitted
R69: 1k; R_0402_1005Metric; PARTNO RC0402FR-071KL; LCSC C106235
TP6, TP7, TP8, TP9, TP108, TP142, TP143, TP144, TP145, TP146, TP147: TestPoint; TestPoint_Pad_D1.0mm
TP12, TP17, TP22, TP27: RST; TestPoint_Pad_1.0x0.4mm
TP13, TP18, TP23: BO; TestPoint_Pad_1.0x0.4mm
TP14, TP19, TP24: RI; TestPoint_Pad_1.0x0.4mm
TP15, TP20, TP25, TP30: CLK; TestPoint_Pad_1.0x0.4mm
TP16, TP21, TP26: CO; TestPoint_Pad_1.0x0.4mm
TP29: RO; TestPoint_Pad_1.0x0.4mm
TP31: CI; TestPoint_Pad_1.0x0.4mm
U4: SN74AVC4T774; TSSOP-16_4.4x5mm_P0.65mm; PARTNO SN74AVC4T774PWR
U5: 25MHz; SMD3225-4P; PARTNO SX3M25.000E20F30THN; LCSC C5137262
U66, U67, U68: MCP1824T-1202E/OT; SOT-23-5; PARTNO MCP1824T-1202E/OT
U69, U70, U71: MCP1824T-0802E; SOT-23-5; PARTNO MCP1824T-0802E/OT
U72, U74: BM1362AC_MODE1; BM1362AC
U73: BM1362AC_MODE0; BM1362AC

Connections:
/3V3: C22.1, U4.15 (VCCB); also elsewhere on the board
/5V: C246.1, C247.1, C248.1, C252.1, C253.1, C254.1, U66.1 (VIN), U66.3 (EN), U67.1 (VIN), U67.3 (EN), U68.1 (VIN), U68.3 (EN), U69.1 (VIN), U69.3 (EN), U70.1 (VIN), U70.3 (EN), U71.1 (VIN), U71.3 (EN); also elsewhere on the board
/RST: U4.14 (B1); also elsewhere on the board
/RX: U4.12 (B3); also elsewhere on the board
/TEMP_N: U74.9 (TEMP_N); also elsewhere on the board
/TEMP_P: U74.8 (TEMP_P); also elsewhere on the board
/TX: U4.13 (B2); also elsewhere on the board
/stack6/BI: R15.2; also elsewhere on the board
/stack6/CI: R12.2; also elsewhere on the board
/stack6/CLKI: R13.2; also elsewhere on the board
/stack6/GND2: C267.1, C273.1, C276.1, U72.25 (VDD); also elsewhere on the board
/stack6/NRSTI: R16.2; also elsewhere on the board
/stack6/RO: R14.2; also elsewhere on the board
/stack7/0V8-0: C255.1, C258.1, TP145.1, U69.5 (VOUT), U72.11 (VDDIO_08_0)
/stack7/0V8-1: C256.1, C259.1, TP146.1, U70.5 (VOUT), U73.11 (VDDIO_08_0)
/stack7/0V8-2: C257.1, C260.1, TP147.1, U71.5 (VOUT), U74.11 (VDDIO_08_0)
/stack7/1V2-0: C249.1, C261.1, TP142.1, U66.5 (VOUT), U72.12 (VDDIO_18_0)
/stack7/1V2-0B: R68.1, U72.13 (VDDIO_18_1)
/stack7/1V2-1: C250.1, C262.1, TP143.1, U67.5 (VOUT), U73.12 (VDDIO_18_0)
/stack7/1V2-2: C21.1, C23.2, C251.1, C263.1, R69.1, TP144.1, U4.7 (DIR3), U4.8 (DIR4), U4.16 (VCCA), U5.1 (EN), U5.4 (VIN), U68.5 (VOUT), U74.12 (VDDIO_18_0)
/stack7/CI: R138.2, TP9.1, TP31.1, U4.4 (A2)
/stack7/CLKI: R137.2, TP8.1, U5.3 (OUT)
/stack7/GND0: C246.2, C249.2, C252.2, C255.2, C258.2, C261.2, C267.2, C268.1, C273.2, C274.1, C276.2, C277.1, J10.1, R17.2, U66.2 (GND), U69.2 (GND), U72.1 (VSS), U72.10 (VSS), U72.15 (PLL_VSS), U72.18 (VSS), U72.24 (VSS), U72.26 (VSS), U73.25 (VDD)
/stack7/GND1: C247.2, C250.2, C253.2, C256.2, C259.2, C262.2, C268.2, C269.1, C274.2, C275.1, C277.2, C278.1, J11.1, R123.2, U67.2 (GND), U70.2 (GND), U73.1 (VSS), U73.10 (VSS), U73.15 (PLL_VSS), U73.17 (PIN_MODE), U73.18 (VSS), U73.24 (VSS), U73.26 (VSS), U74.25 (VDD)
/stack7/RO: R69.2, R136.2, TP7.1, TP29.1, U4.5 (A3)
/stack7/RST_N: R135.2, TP6.1, TP27.1, U4.3 (A1)
GND: C21.2, C22.2, C23.1, C248.2, C251.2, C254.2, C257.2, C260.2, C263.2, C269.2, C275.2, C278.2, R18.2, R134.2, U4.1 (DIR1), U4.2 (DIR2), U4.6 (A4), U4.9 (OE), U4.10 (GND), U5.2 (GND), U68.2 (GND), U71.2 (GND), U74.1 (VSS), U74.10 (VSS), U74.15 (PLL_VSS), U74.18 (VSS), U74.24 (VSS), U74.26 (VSS); also elsewhere on the board
unnamed: R125.1, U72.3 (BI)
unnamed: R15.1, TP23.1, U72.22 (BO)
unnamed: R128.1, U72.6 (CI)
unnamed: R127.1, U72.5 (CLKI)
unnamed: R13.1, TP25.1, U72.20 (CLKO)
unnamed: R12.1, TP26.1, U72.19 (CO)
unnamed: R124.1, U72.2 (NRSTI)
unnamed: R16.1, R17.1, TP22.1, U72.23 (NRSTO)
unnamed: R14.1, R68.2, TP24.1, TP108.1, U72.21 (RI)
unnamed: R126.1, U72.4 (RO)
unnamed: R130.1, U73.20 (BI)
unnamed: R125.2, TP18.1, U73.5 (BO)
unnamed: R133.1, U73.23 (CI)
unnamed: R132.1, U73.22 (CLKI)
unnamed: R127.2, TP20.1, U73.3 (CLKO)
unnamed: R128.2, TP21.1, U73.2 (CO)
unnamed: R129.1, U73.19 (NRSTI)
unnamed: R123.1, R124.2, TP17.1, U73.6 (NRSTO)
unnamed: R126.2, TP19.1, U73.4 (RI)
unnamed: R131.1, U73.21 (RO)
unnamed: R18.1, U74.3 (BI)
unnamed: R130.2, TP13.1, U74.22 (BO)
unnamed: R138.1, U74.6 (CI)
unnamed: R137.1, TP30.1, U74.5 (CLKI)
unnamed: R132.2, TP15.1, U74.20 (CLKO)
unnamed: R133.2, TP16.1, U74.19 (CO)
unnamed: R135.1, U74.2 (NRSTI)
unnamed: R129.2, R134.1, TP12.1, U74.23 (NRSTO)
unnamed: R131.2, TP14.1, U74.21 (RI)
unnamed: R136.1, U74.4 (RO)

Notes on the sheet:
Reference Voltage Regulators
Direction Control HIGH= A -> B LOW = A <- B

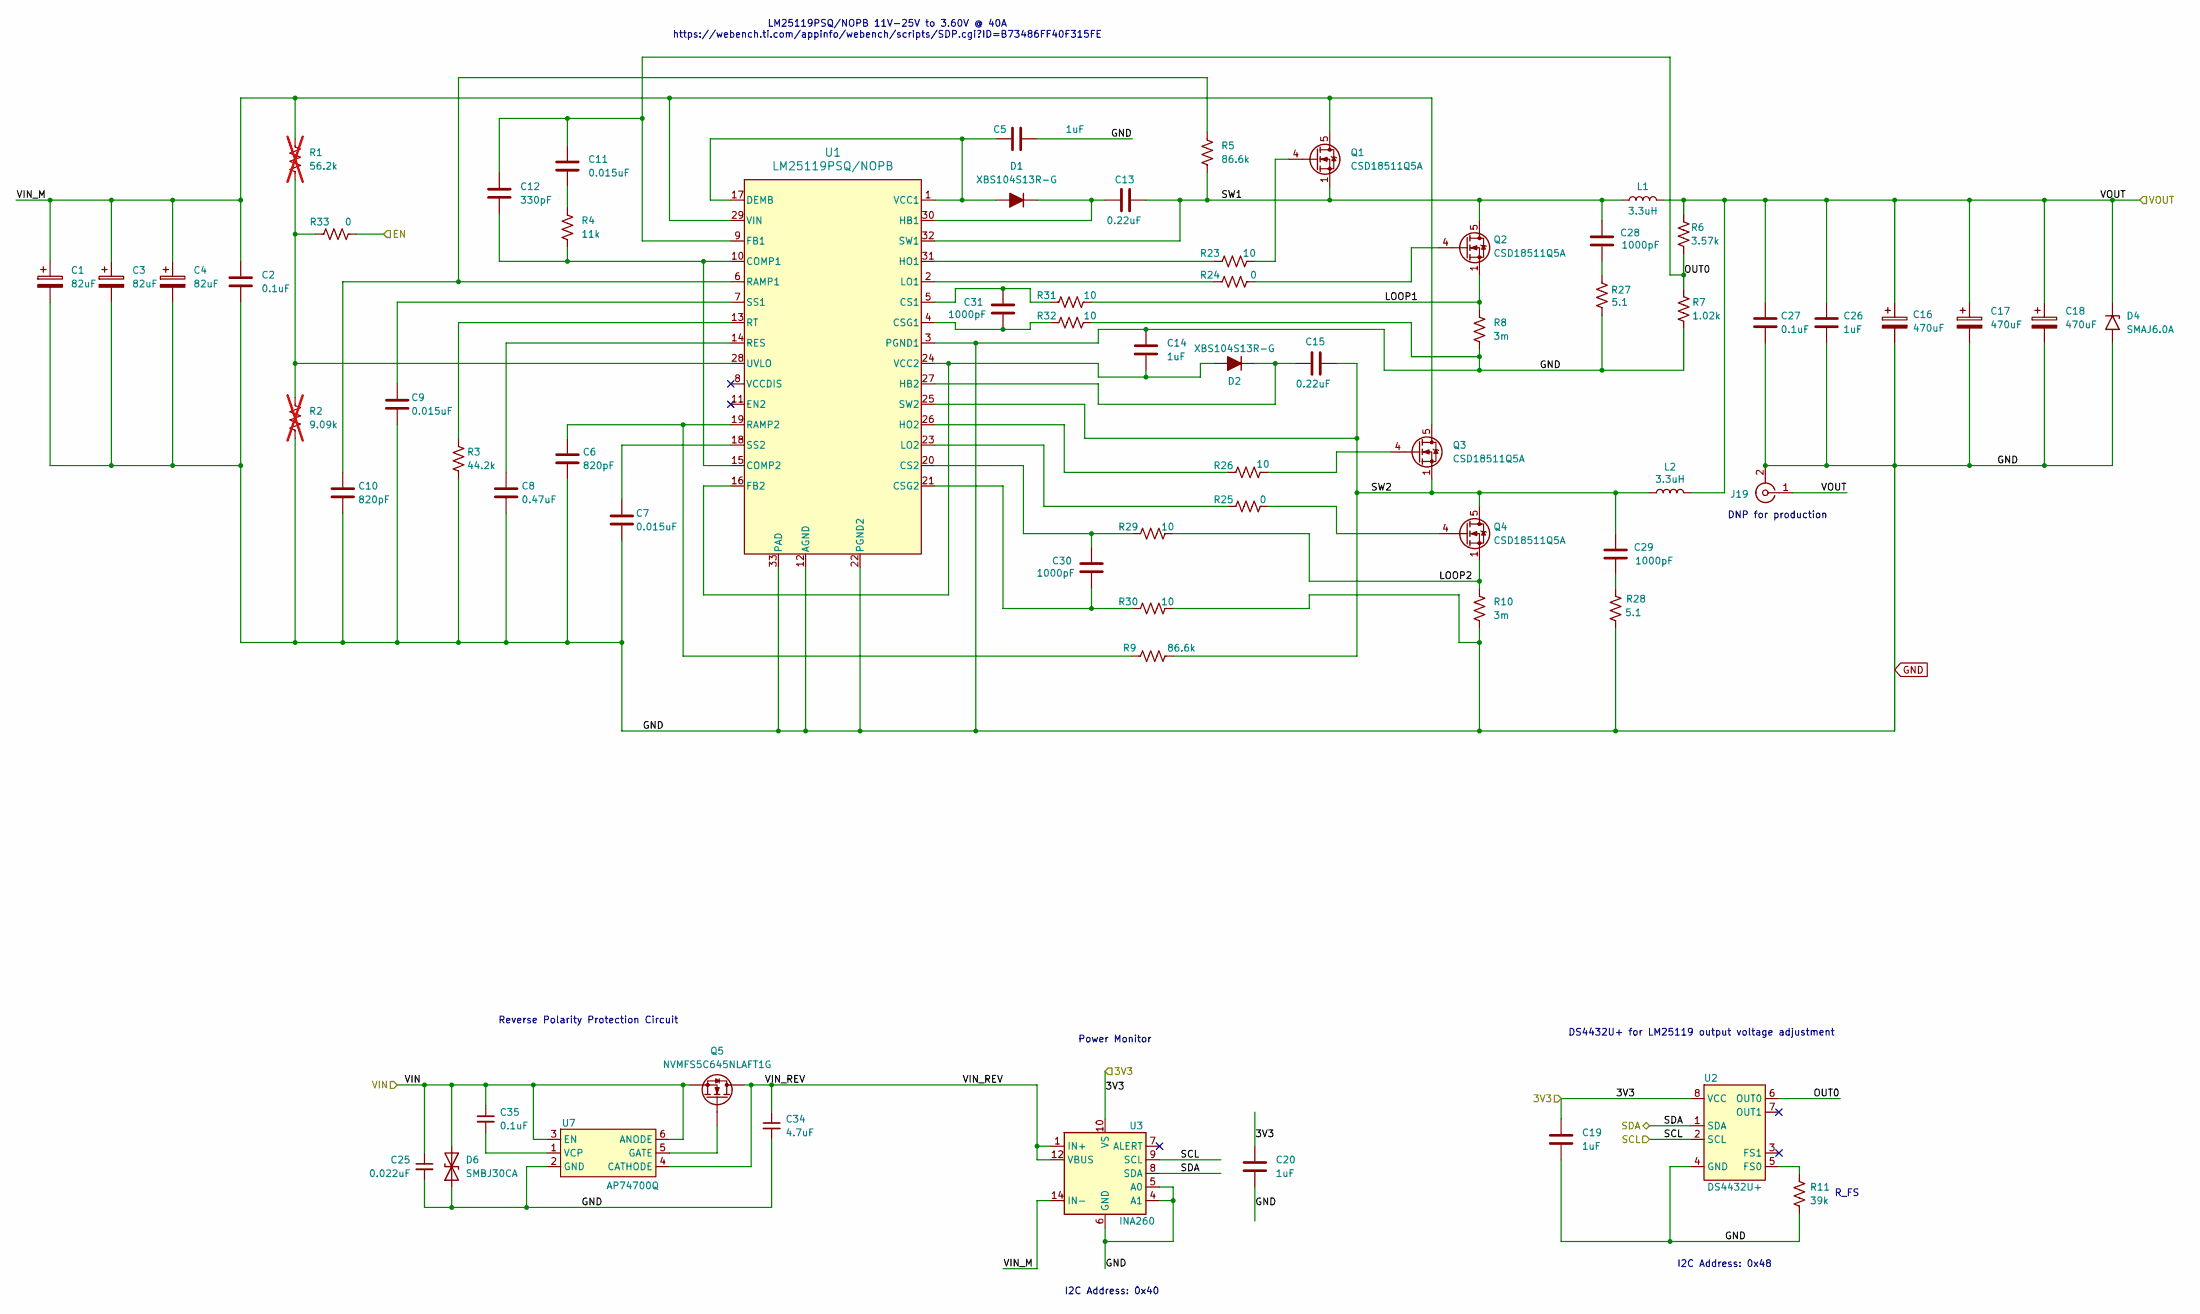
[picture p4: schematic power.kicad_sch, emberOne/00]

Parts:
C1, C3, C4: 82uF; PCAP_SVP_E12_PAN; PARTNO 35SVPF82M
C2, C27, C35: 0.1uF; C_0805_2012Metric; PARTNO CC0805KRX7R9BB104
C5, C14, C19, C20, C26: 1uF; C_0805_2012Metric; PARTNO CL21B105KBFNNNG
C6, C10: 820pF; C_0805_2012Metric; PARTNO C0805C821J5GACTU
C7, C9, C11: 0.015uF; C_0805_2012Metric; PARTNO C0805C153K5RAC7800
C8: 0.47uF; C_0805_2012Metric; PARTNO CL21B474KBFNNNG
C12: 330pF; C_0805_2012Metric; PARTNO C0805C331J5GAC7800
C13, C15: 0.22uF; C_0805_2012Metric; PARTNO CL21B224KBFNFNE
C16, C17, C18: 470uF; CHEMI-H80; PARTNO APXF6R3ARA471MH80G
C25: 0.022uF; C_0402_1005Metric; PARTNO GRM155R71H223KA12J
C28, C29, C30, C31: 1000pF; C_0805_2012Metric; PARTNO C2012C0G2A102J060AA
C34: 4.7uF; C_0805_2012Metric; PARTNO GRM21BR61H475ME51L
D1, D2: XBS104S13R-G; SDO_4S13R-G_TOR; PARTNO XBS104S13R-G
D4: SMAJ6.0A; D_SMB; PARTNO SMBJP6KE6.8A-TP
D6: SMBJ30CA; D_SMB; PARTNO SMBJ30CA
J19: Conn_Coaxial; SAMTEC_MMCX-P-P-H-ST-TH1; PARTNO MMCX-P-P-H-ST-TH1
L1, L2: 3.3uH; IND_SER2915L_COC; PARTNO SER2915L-332KL
Q1, Q2, Q3, Q4: CSD18511Q5A; DQJ0008A; PARTNO CSD18511Q5A
Q5: NVMFS5C645NLAFT1G; DIO_NTS1045EMFST1G; PARTNO NVMFS5C645NLAFT1G
R1: 56.2k; R_0603_1608Metric; PARTNO RC0603FR-0756K2L; not fitted
R2: 9.09k; R_0603_1608Metric; PARTNO RC0603FR-079K09L; not fitted
R3: 44.2k; R_0603_1608Metric; PARTNO RC0603FR-0744K2L
R4: 11k; R_0603_1608Metric; PARTNO RC0603FR-0711KL
R5, R9: 86.6k; R_0603_1608Metric; PARTNO RC0603FR-0786K6L
R6: 3.57k; R_0603_1608Metric; PARTNO RC0603FR-073K57L
R7: 1.02k; R_0603_1608Metric; PARTNO RC0603FR-071K02L
R8, R10: 3m; WSR-4527; PARTNO WSR23L000FEA
R11: 39k; R_0402_1005Metric; PARTNO RC0402FR-0739KL
R23, R26, R29, R30, R31, R32: 10; R_0603_1608Metric; PARTNO RC0603FR-0710RL
R24, R25, R33: 0; R_0603_1608Metric; PARTNO RC0603FR-070RL
R27, R28: 5.1; R_2512_6332Metric; PARTNO ERJ-1TRQF5R1U
U1: LM25119PSQ/NOPB; SQA32A; PARTNO LM25119PSQ/NOPB
U2: DS4432U+; TSSOP-8_3x3mm_P0.65mm; PARTNO DS4432U+
U3: INA260; TSSOP-16_4.4x5mm_P0.65mm; PARTNO INA260AIPWR
U7: AP74700Q; SOT-23-6; PARTNO AP74700QW6-7

Connections:
/3V3: C19.1, C20.1, U2.8 (VCC), U3.10 (VS); also elsewhere on the board
/3V6: C16.1, C17.1, C18.1, C26.1, C27.1, D4.1 (A1), J19.1 (In), L1.1, L2.2, R6.1; also elsewhere on the board
/Data/PWR_EN: R33.1; also elsewhere on the board
/Data/SCL: U2.2 (SCL), U3.9 (SCL); also elsewhere on the board
/Data/SDA: U2.1 (SDA), U3.8 (SDA); also elsewhere on the board
/Power/LOOP1: Q2.1 (S), Q2.2 (S), Q2.3 (S), R8.1, R31.2
/Power/LOOP2: Q4.1 (S), Q4.2 (S), Q4.3 (S), R10.1, R29.2
/Power/OUT0: C11.1, C12.1, R6.2, R7.1, U1.9 (FB1), U2.6 (OUT0)
/Power/SW1: C13.2, C28.1, L1.2, Q1.1 (S), Q1.2 (S), Q1.3 (S), Q2.5 (D), Q2.6 (D), Q2.7 (D), Q2.8 (D), R5.2, U1.32 (SW1)
/Power/SW2: C15.2, C29.1, L2.1, Q3.1 (S), Q3.2 (S), Q3.3 (S), Q4.5 (D), Q4.6 (D), Q4.7 (D), Q4.8 (D), R9.2, U1.25 (SW2)
/Power/VIN: C25.1, C35.1, D6.2 (A2), Q5.S, U7.3 (EN), U7.6 (ANODE); also elsewhere on the board
/Power/VIN_M: C1.1, C2.1, C3.1, C4.1, Q1.5 (D), Q1.6 (D), Q1.7 (D), Q1.8 (D), Q3.5 (D), Q3.6 (D), Q3.7 (D), Q3.8 (D), R1.1, U1.29 (VIN), U3.14 (IN-), U3.15 (IN-), U3.16 (IN-)
/Power/VIN_REV: C34.1, Q5.D, U3.1 (IN+), U3.2 (IN+), U3.3 (IN+), U3.12 (VBUS), U7.4 (CATHODE)
GND: C1.2, C2.2, C3.2, C4.2, C5.2, C6.2, C7.2, C8.2, C9.2, C10.2, C14.1, C16.2, C17.2, C18.2, C19.2, C20.2, C25.2, C26.2, C27.2, C34.2, D4.2 (A2), D6.1 (A1), J19.2 (Ext), R2.2, R3.2, R7.2, R8.2, R10.2, R11.2, R27.2, R28.2, R30.2, R32.2, U1.3 (PGND1), U1.12 (AGND), U1.22 (PGND2), U1.33 (PAD), U2.4 (GND), U3.4 (A1), U3.5 (A0), U3.6 (GND), U3.11 (GND), U7.2 (GND); also elsewhere on the board
unnamed: C11.2, R4.1
unnamed: C28.2, R27.1
unnamed: C29.2, R28.1
unnamed: C5.1, D1.2 (A), U1.1 (VCC1), U1.17 (DEMB)
unnamed: C13.1, D1.1 (K), U1.30 (HB1)
unnamed: C14.2, D2.2 (A), U1.16 (FB2), U1.24 (VCC2)
unnamed: C15.1, D2.1 (K), U1.27 (HB2)
unnamed: Q1.4 (G), R23.2
unnamed: Q2.4 (G), R24.2
unnamed: Q3.4 (G), R26.2
unnamed: Q4.4 (G), R25.2
unnamed: C12.2, R4.2, U1.10 (COMP1), U1.15 (COMP2)
unnamed: C31.2, R31.1, U1.5 (CS1)
unnamed: C30.2, R29.1, U1.20 (CS2)
unnamed: C31.1, R32.1, U1.4 (CSG1)
unnamed: C30.1, R30.1, U1.21 (CSG2)
unnamed: R23.1, U1.31 (HO1)
unnamed: R26.1, U1.26 (HO2)
unnamed: R24.1, U1.2 (LO1)
unnamed: R25.1, U1.23 (LO2)
unnamed: C10.1, R5.1, U1.6 (RAMP1)
unnamed: C6.1, R9.1, U1.19 (RAMP2)
unnamed: C8.1, U1.14 (RES)
unnamed: R3.1, U1.13 (RT)
unnamed: C9.1, U1.7 (SS1)
unnamed: C7.1, U1.18 (SS2)
unnamed: R1.2, R2.1, R33.2, U1.28 (UVLO)
unnamed: R11.1, U2.5 (FS0)
unnamed: Q5.G, U7.5 (GATE)
unnamed: C35.2, U7.1 (VCP)

Notes on the sheet:
Reverse Polarity Protection Circuit
I2C Address: 0x40
I2C Address: 0x48
R_FS
LM25119PSQ/NOPB 11V-25V to 3.60V @ 40A https://webench.ti.com/appinfo/webench/scripts/SDP.cgi?ID=B73486FF40F315FE
DS4432U+ for LM25119 output voltage adjustment
DNP for production
Power Monitor
