256-Foundation/emberone00-pcb/emberone.kicad_pcb

## KiCad design emberone.kicad_pcb (continued)

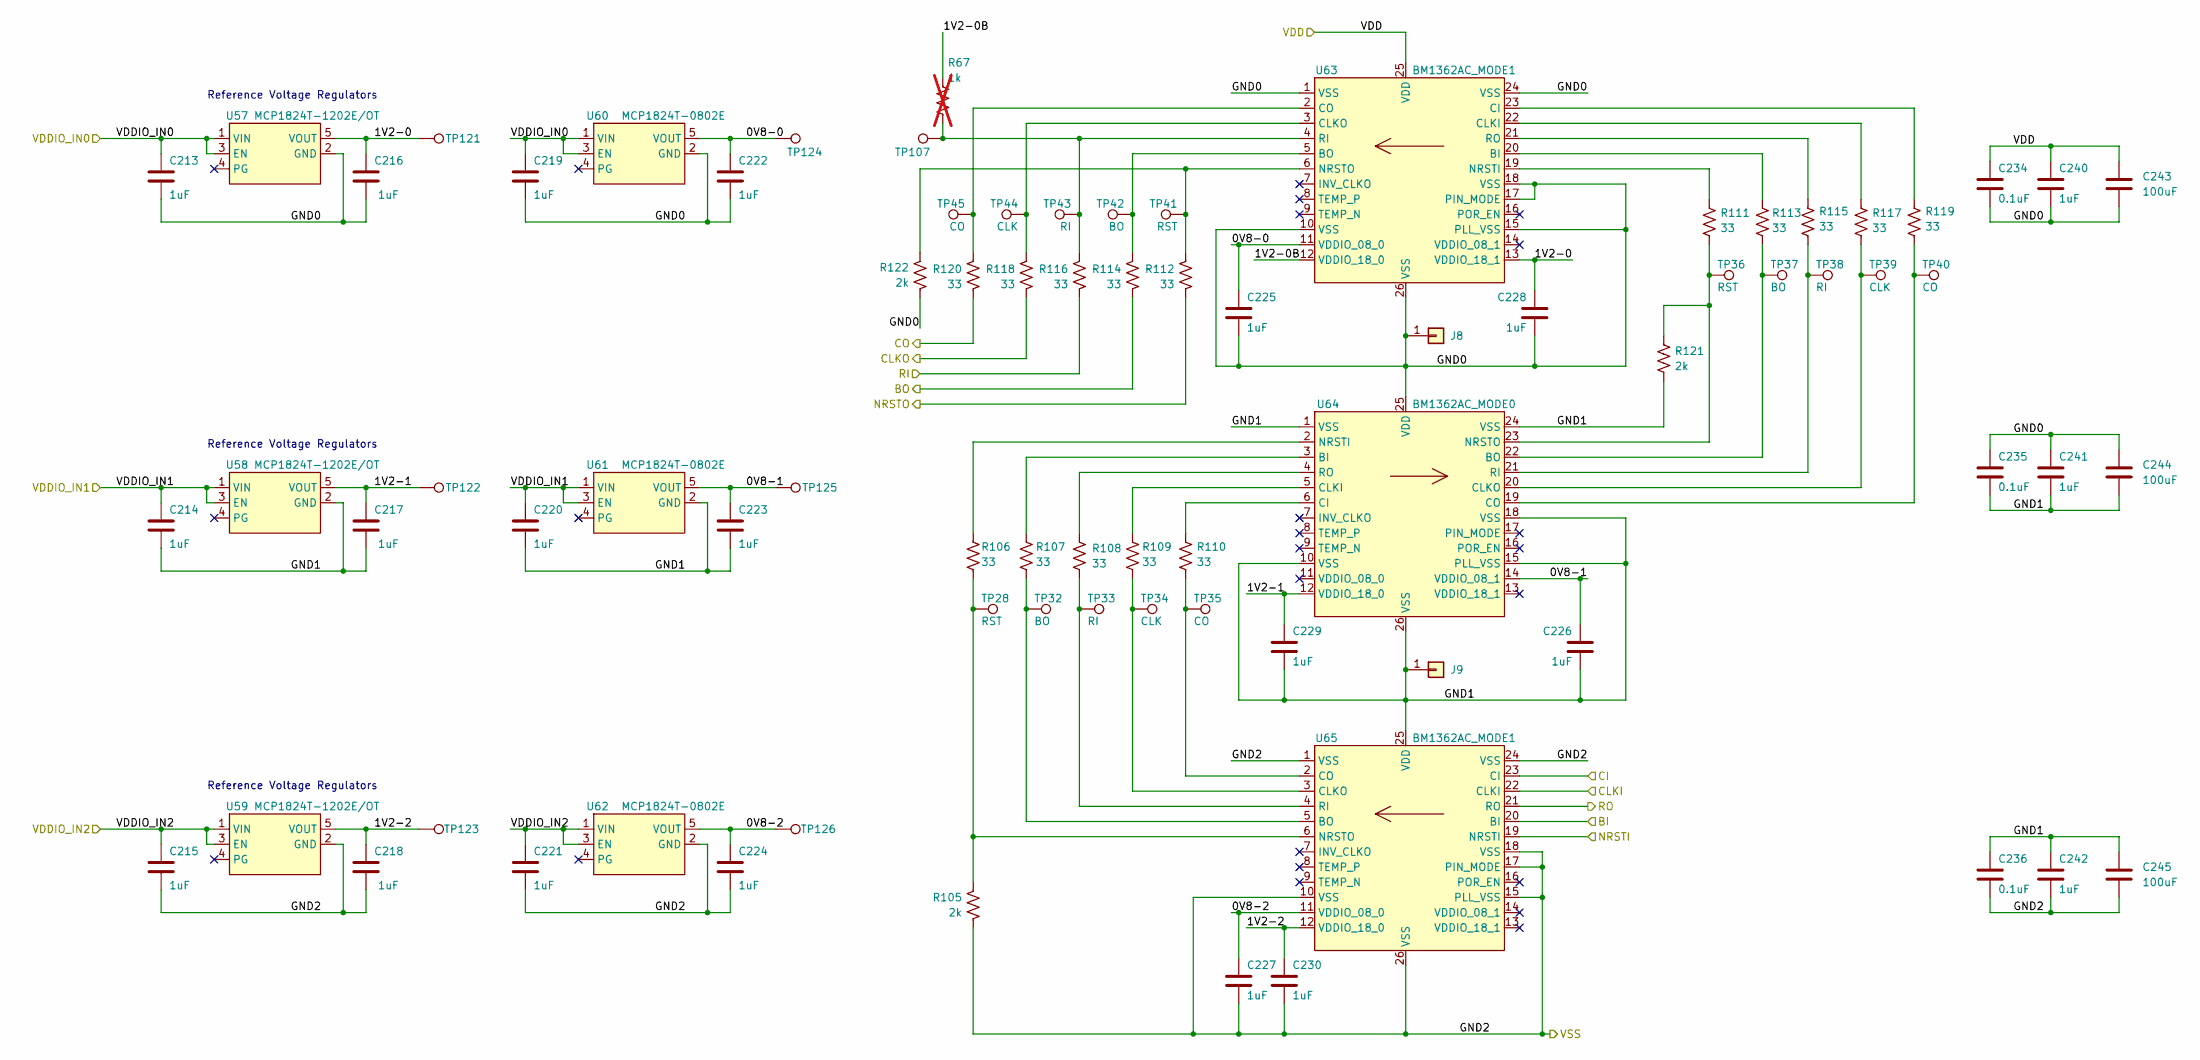
[picture p5: schematic asic-3up-2.kicad_sch, emberOne/00]

Parts:
C213, C214, C215, C216, C217, C218, C219, C220, C221, C222, C223, C224, C225, C226, C227, C228, C229, C230, C240, C241, C242: 1uF; C_0402_1005Metric; PARTNO EMK105BJ105MV-F; LCSC C52923
C234, C235, C236: 0.1uF; C_0402_1005Metric; PARTNO KGM05AR71C104KH; LCSC C307331
C243, C244, C245: 100uF; C_1206_3216Metric; PARTNO CL31A107MQHNNNE; LCSC C15008
J8, J9: Conn_01x01; 5x9_powertab
R67: 1k; R_0402_1005Metric; not fitted
R105, R121, R122: 2k; R_0402_1005Metric; PARTNO RC0402FR-072KL; LCSC C60488
R106, R107, R108, R109, R110, R111, R112, R113, R114, R115, R116, R117, R118, R119, R120: 33; R_0402_1005Metric; PARTNO RC0402FR-0733RL; LCSC C25105
TP28, TP36, TP41: RST; TestPoint_Pad_1.0x0.4mm
TP32, TP37, TP42: BO; TestPoint_Pad_1.0x0.4mm
TP33, TP38, TP43: RI; TestPoint_Pad_1.0x0.4mm
TP34, TP39, TP44: CLK; TestPoint_Pad_1.0x0.4mm
TP35, TP40, TP45: CO; TestPoint_Pad_1.0x0.4mm
TP107, TP121, TP122, TP123, TP124, TP125, TP126: TestPoint; TestPoint_Pad_D1.0mm
U57, U58, U59: MCP1824T-1202E/OT; SOT-23-5; PARTNO MCP1824T-1202E/OT
U60, U61, U62: MCP1824T-0802E; SOT-23-5; PARTNO MCP1824T-0802E/OT
U63, U65: BM1362AC_MODE1; BM1362AC
U64: BM1362AC_MODE0; BM1362AC

Connections:
/5V: C213.1, C214.1, C215.1, C219.1, C220.1, C221.1, U57.1 (VIN), U57.3 (EN), U58.1 (VIN), U58.3 (EN), U59.1 (VIN), U59.3 (EN), U60.1 (VIN), U60.3 (EN), U61.1 (VIN), U61.3 (EN), U62.1 (VIN), U62.3 (EN); also elsewhere on the board
/stack5/BI: R114.2; also elsewhere on the board
/stack5/CI: R120.2; also elsewhere on the board
/stack5/CLKI: R118.2; also elsewhere on the board
/stack5/GND2: C234.1, C240.1, C243.1, U63.25 (VDD); also elsewhere on the board
/stack5/NRSTI: R112.2; also elsewhere on the board
/stack5/RO: R116.2; also elsewhere on the board
/stack6/0V8-0: C222.1, C225.1, TP124.1, U60.5 (VOUT), U63.11 (VDDIO_08_0)
/stack6/0V8-1: C223.1, C226.1, TP125.1, U61.5 (VOUT), U64.14 (VDDIO_08_1)
/stack6/0V8-2: C224.1, C227.1, TP126.1, U62.5 (VOUT), U65.11 (VDDIO_08_0)
/stack6/1V2-0: C216.1, C228.1, TP121.1, U57.5 (VOUT), U63.13 (VDDIO_18_1)
/stack6/1V2-0B: R67.1, U63.12 (VDDIO_18_0)
/stack6/1V2-1: C217.1, C229.1, TP122.1, U58.5 (VOUT), U64.12 (VDDIO_18_0)
/stack6/1V2-2: C218.1, C230.1, TP123.1, U59.5 (VOUT), U65.12 (VDDIO_18_0)
/stack6/BI: U65.20 (BI); also elsewhere on the board
/stack6/CI: U65.23 (CI); also elsewhere on the board
/stack6/CLKI: U65.22 (CLKI); also elsewhere on the board
/stack6/GND0: C213.2, C216.2, C219.2, C222.2, C225.2, C228.2, C234.2, C235.1, C240.2, C241.1, C243.2, C244.1, J8.1, R122.2, U57.2 (GND), U60.2 (GND), U63.1 (VSS), U63.10 (VSS), U63.15 (PLL_VSS), U63.17 (PIN_MODE), U63.18 (VSS), U63.24 (VSS), U63.26 (VSS), U64.25 (VDD)
/stack6/GND1: C214.2, C217.2, C220.2, C223.2, C226.2, C229.2, C235.2, C236.1, C241.2, C242.1, C244.2, C245.1, J9.1, R121.2, U58.2 (GND), U61.2 (GND), U64.1 (VSS), U64.10 (VSS), U64.15 (PLL_VSS), U64.18 (VSS), U64.24 (VSS), U64.26 (VSS), U65.25 (VDD)
/stack6/GND2: C215.2, C218.2, C221.2, C224.2, C227.2, C230.2, C236.2, C242.2, C245.2, R105.2, U59.2 (GND), U62.2 (GND), U65.1 (VSS), U65.10 (VSS), U65.15 (PLL_VSS), U65.17 (PIN_MODE), U65.18 (VSS), U65.24 (VSS), U65.26 (VSS); also elsewhere on the board
/stack6/NRSTI: U65.19 (NRSTI); also elsewhere on the board
/stack6/RO: U65.21 (RO); also elsewhere on the board
unnamed: R113.1, U63.20 (BI)
unnamed: R114.1, TP42.1, U63.5 (BO)
unnamed: R119.1, U63.23 (CI)
unnamed: R117.1, U63.22 (CLKI)
unnamed: R118.1, TP44.1, U63.3 (CLKO)
unnamed: R120.1, TP45.1, U63.2 (CO)
unnamed: R111.1, U63.19 (NRSTI)
unnamed: R112.1, R122.1, TP41.1, U63.6 (NRSTO)
unnamed: R67.2, R116.1, TP43.1, TP107.1, U63.4 (RI)
unnamed: R115.1, U63.21 (RO)
unnamed: R107.1, U64.3 (BI)
unnamed: R113.2, TP37.1, U64.22 (BO)
unnamed: R110.1, U64.6 (CI)
unnamed: R109.1, U64.5 (CLKI)
unnamed: R117.2, TP39.1, U64.20 (CLKO)
unnamed: R119.2, TP40.1, U64.19 (CO)
unnamed: R106.1, U64.2 (NRSTI)
unnamed: R111.2, R121.1, TP36.1, U64.23 (NRSTO)
unnamed: R115.2, TP38.1, U64.21 (RI)
unnamed: R108.1, U64.4 (RO)
unnamed: R107.2, TP32.1, U65.5 (BO)
unnamed: R109.2, TP34.1, U65.3 (CLKO)
unnamed: R110.2, TP35.1, U65.2 (CO)
unnamed: R105.1, R106.2, TP28.1, U65.6 (NRSTO)
unnamed: R108.2, TP33.1, U65.4 (RI)

Notes on the sheet:
Reference Voltage Regulators

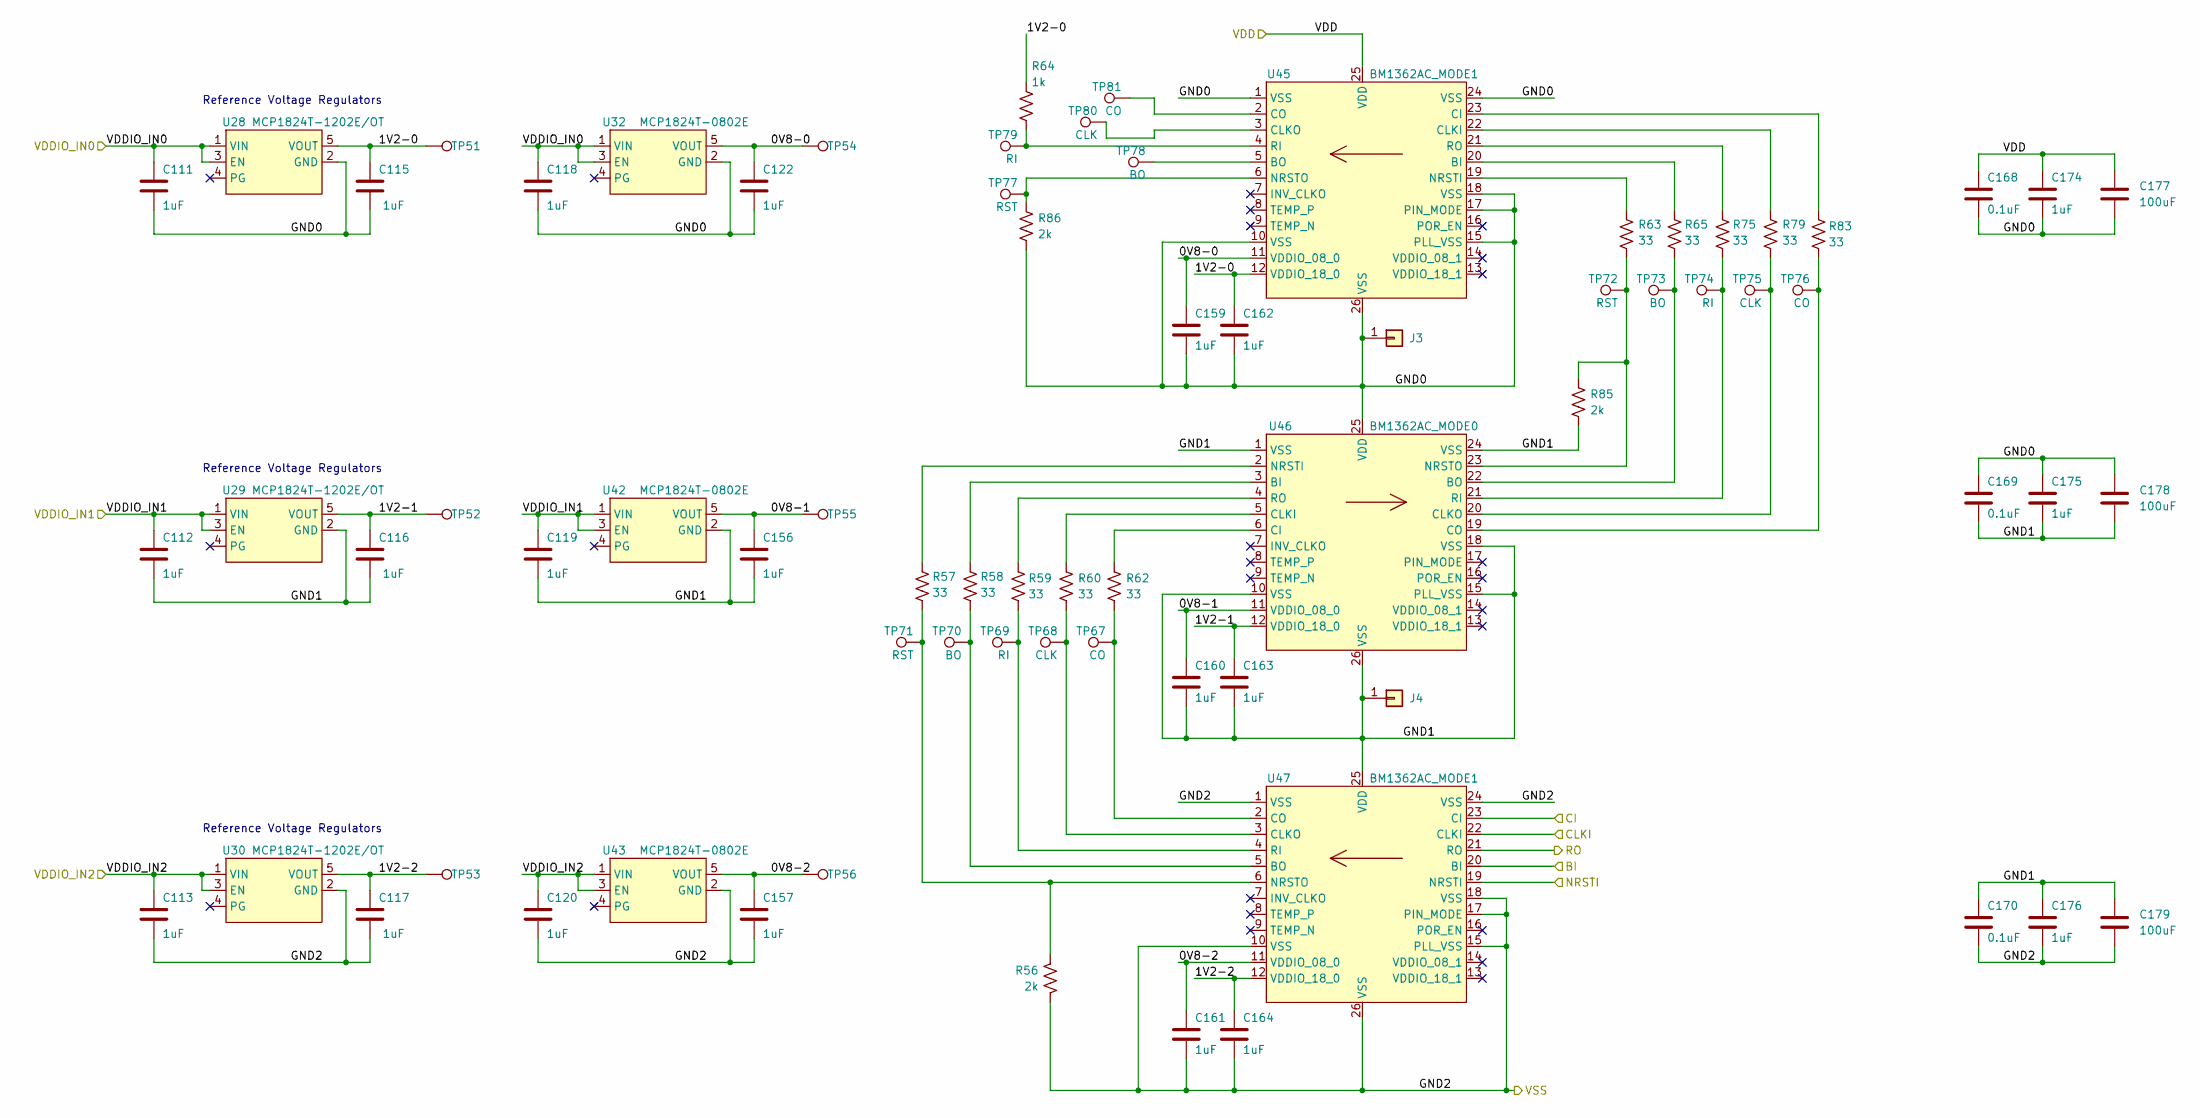
[picture p6: schematic asic-3up-0.kicad_sch, emberOne/00]

Parts:
C111, C112, C113, C115, C116, C117, C118, C119, C120, C122, C156, C157, C159, C160, C161, C162, C163, C164, C174, C175, C176: 1uF; C_0402_1005Metric; PARTNO EMK105BJ105MV-F; LCSC C52923
C168, C169, C170: 0.1uF; C_0402_1005Metric; PARTNO KGM05AR71C104KH; LCSC C307331
C177, C178, C179: 100uF; C_1206_3216Metric; PARTNO CL31A107MQHNNNE; LCSC C15008
J3, J4: Conn_01x01; 5x9_powertab
R56, R85, R86: 2k; R_0402_1005Metric; PARTNO RC0402FR-072KL; LCSC C60488
R57, R58, R59, R60, R62, R63, R65, R75, R79, R83: 33; R_0402_1005Metric; PARTNO RC0402FR-0733RL; LCSC C25105
R64: 1k; R_0402_1005Metric; PARTNO RC0402FR-071KL; LCSC C106235
TP51, TP52, TP53, TP54, TP55, TP56: TestPoint; TestPoint_Pad_D1.0mm
TP67, TP76, TP81: CO; TestPoint_Pad_1.0x0.4mm
TP68, TP75, TP80: CLK; TestPoint_Pad_1.0x0.4mm
TP69, TP74, TP79: RI; TestPoint_Pad_1.0x0.4mm
TP70, TP73, TP78: BO; TestPoint_Pad_1.0x0.4mm
TP71, TP72, TP77: RST; TestPoint_Pad_1.0x0.4mm
U28, U29, U30: MCP1824T-1202E/OT; SOT-23-5; PARTNO MCP1824T-1202E/OT
U32, U42, U43: MCP1824T-0802E; SOT-23-5; PARTNO MCP1824T-0802E/OT
U45, U47: BM1362AC_MODE1; BM1362AC
U46: BM1362AC_MODE0; BM1362AC

Connections:
/3V6: C168.1, C174.1, C177.1, U45.25 (VDD); also elsewhere on the board
/5V: C111.1, C112.1, C113.1, C118.1, C119.1, C120.1, U28.1 (VIN), U28.3 (EN), U29.1 (VIN), U29.3 (EN), U30.1 (VIN), U30.3 (EN), U32.1 (VIN), U32.3 (EN), U42.1 (VIN), U42.3 (EN), U43.1 (VIN), U43.3 (EN); also elsewhere on the board
/stack4/0V8-0: C122.1, C159.1, TP54.1, U32.5 (VOUT), U45.11 (VDDIO_08_0)
/stack4/0V8-1: C156.1, C160.1, TP55.1, U42.5 (VOUT), U46.11 (VDDIO_08_0)
/stack4/0V8-2: C157.1, C161.1, TP56.1, U43.5 (VOUT), U47.11 (VDDIO_08_0)
/stack4/1V2-0: C115.1, C162.1, R64.1, TP51.1, U28.5 (VOUT), U45.12 (VDDIO_18_0)
/stack4/1V2-1: C116.1, C163.1, TP52.1, U29.5 (VOUT), U46.12 (VDDIO_18_0)
/stack4/1V2-2: C117.1, C164.1, TP53.1, U30.5 (VOUT), U47.12 (VDDIO_18_0)
/stack4/BI: U47.20 (BI); also elsewhere on the board
/stack4/CI: U47.23 (CI); also elsewhere on the board
/stack4/CLKI: U47.22 (CLKI); also elsewhere on the board
/stack4/GND0: C111.2, C115.2, C118.2, C122.2, C159.2, C162.2, C168.2, C169.1, C174.2, C175.1, C177.2, C178.1, J3.1, R86.2, U28.2 (GND), U32.2 (GND), U45.1 (VSS), U45.10 (VSS), U45.15 (PLL_VSS), U45.17 (PIN_MODE), U45.18 (VSS), U45.24 (VSS), U45.26 (VSS), U46.25 (VDD)
/stack4/GND1: C112.2, C116.2, C119.2, C156.2, C160.2, C163.2, C169.2, C170.1, C175.2, C176.1, C178.2, C179.1, J4.1, R85.2, U29.2 (GND), U42.2 (GND), U46.1 (VSS), U46.10 (VSS), U46.15 (PLL_VSS), U46.18 (VSS), U46.24 (VSS), U46.26 (VSS), U47.25 (VDD)
/stack4/GND2: C113.2, C117.2, C120.2, C157.2, C161.2, C164.2, C170.2, C176.2, C179.2, R56.2, U30.2 (GND), U43.2 (GND), U47.1 (VSS), U47.10 (VSS), U47.15 (PLL_VSS), U47.17 (PIN_MODE), U47.18 (VSS), U47.24 (VSS), U47.26 (VSS); also elsewhere on the board
/stack4/NRSTI: U47.19 (NRSTI); also elsewhere on the board
/stack4/RO: U47.21 (RO); also elsewhere on the board
unnamed: R65.1, U45.20 (BI)
unnamed: TP78.1, U45.5 (BO)
unnamed: R83.1, U45.23 (CI)
unnamed: R79.1, U45.22 (CLKI)
unnamed: TP80.1, U45.3 (CLKO)
unnamed: TP81.1, U45.2 (CO)
unnamed: R63.1, U45.19 (NRSTI)
unnamed: R86.1, TP77.1, U45.6 (NRSTO)
unnamed: R64.2, TP79.1, U45.4 (RI)
unnamed: R75.1, U45.21 (RO)
unnamed: R58.1, U46.3 (BI)
unnamed: R65.2, TP73.1, U46.22 (BO)
unnamed: R62.1, U46.6 (CI)
unnamed: R60.1, U46.5 (CLKI)
unnamed: R79.2, TP75.1, U46.20 (CLKO)
unnamed: R83.2, TP76.1, U46.19 (CO)
unnamed: R57.1, U46.2 (NRSTI)
unnamed: R63.2, R85.1, TP72.1, U46.23 (NRSTO)
unnamed: R75.2, TP74.1, U46.21 (RI)
unnamed: R59.1, U46.4 (RO)
unnamed: R58.2, TP70.1, U47.5 (BO)
unnamed: R60.2, TP68.1, U47.3 (CLKO)
unnamed: R62.2, TP67.1, U47.2 (CO)
unnamed: R56.1, R57.2, TP71.1, U47.6 (NRSTO)
unnamed: R59.2, TP69.1, U47.4 (RI)

Notes on the sheet:
Reference Voltage Regulators

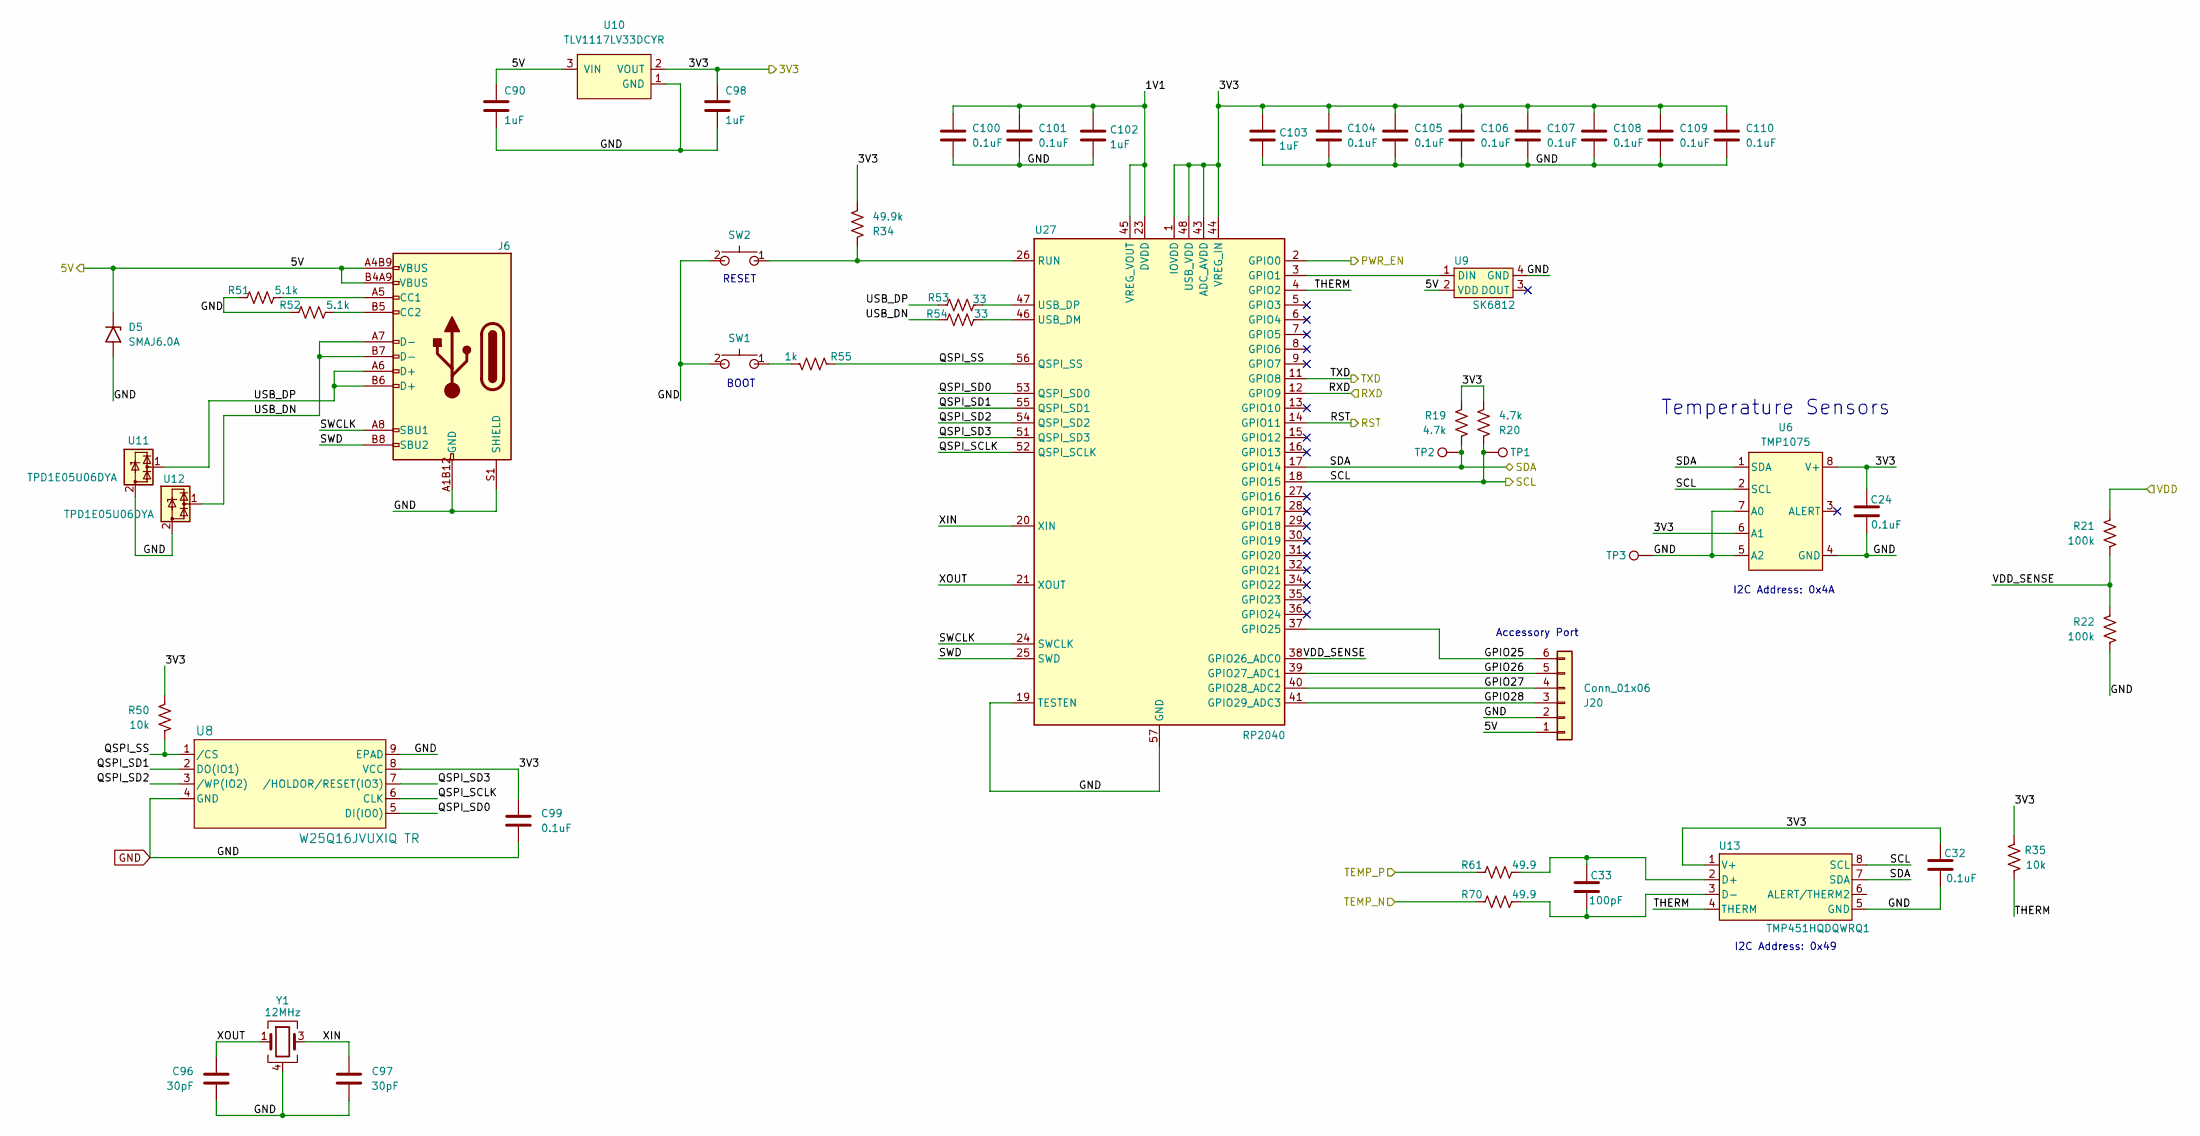
[picture p7: schematic data.kicad_sch, emberOne/00]

Parts:
C24, C32, C99, C100, C101, C104, C105, C106, C107, C108, C109, C110: 0.1uF; C_0402_1005Metric; PARTNO KGM05AR71C104KH; LCSC C307331
C33: 100pF; C_0402_1005Metric; PARTNO CC0402JRNPO9BN101
C90, C98, C102, C103: 1uF; C_0402_1005Metric; PARTNO EMK105BJ105MV-F; LCSC C52923
C96, C97: 30pF; C_0402_1005Metric; PARTNO GRM1555C1H300JA01D; LCSC C1570
D5: SMAJ6.0A; D_SMB; PARTNO SMBJP6KE6.8A-TP
J6: USB_C_Receptacle_USB2.0; USB_C_Receptacle_GCT_USB4105-xx-A_16P_TopMnt_Horizontal; PARTNO USB4105-GF-A; LCSC C2988369
J20: Conn_01x06; PinHeader_1x06_P2.54mm_Vertical_SMD_Pin1Right
R19, R20: 4.7k; R_0402_1005Metric; PARTNO RC0402FR-074K7L
R21, R22: 100k; R_0402_1005Metric; PARTNO RC0402FR-07100KL
R34: 49.9k; R_0402_1005Metric; PARTNO RC0402FR-0749K9L
R35, R50: 10k; R_0402_1005Metric; PARTNO RC0402FR-0710KL; LCSC C25744
R51, R52: 5.1k; R_0402_1005Metric; PARTNO RMCF0402JT5K10; LCSC C25905
R53, R54: 33; R_0402_1005Metric; PARTNO RC0402FR-0733RL; LCSC C25105
R55: 1k; R_0402_1005Metric; PARTNO RC0402FR-071KL; LCSC C106235
R61, R70: 49.9; R_0402_1005Metric; PARTNO RC0402FR-0749R9L
SW1, SW2: GT-TC029B-H025-L1N; SW_CS1213AGF260_CRS; PARTNO CS1213AGF260
TP1, TP2, TP3: TestPoint; TestPoint_Pad_D1.0mm
U6: TMP1075; HVSSOP-8_3x3mm_P0.65mm; PARTNO TMP1075DGKR
U8: W25Q16JVUXIQ TR; USON-8_UX_2x3x0p6_WIN; PARTNO W25Q16JVUXIQ TR; LCSC C2843335
U9: SK6812; LED-SMD_4P-L4.0-W1.6-L; LCSC C2890037
U10: TLV1117LV33DCYR; VREG_TLV1117LV33DCYR; PARTNO TLV1117LV33DCYR
U11, U12: TPD1E05U06DYA; D_SOD-523; PARTNO TPD1E05U06DYAR
U13: TMP451HQDQWRQ1; DQF0008A; PARTNO TMP451HQDQWRQ1
U27: RP2040; QFN-56-1EP_7x7mm_P0.4mm_EP3.2x3.2mm; PARTNO SC0914(13); LCSC C2040
Y1: 12MHz; XTAL_ECS-120-20-33-CKM-TR3; PARTNO ECS-120-20-33-CKM-TR3; LCSC C9002

Connections:
/3V3: C24.1, C32.1, C98.1, C99.2, C103.2, C104.2, C105.2, C106.2, C107.2, C108.2, C109.2, C110.2, R19.1, R20.2, R34.2, R35.1, R50.1, U6.6 (A1), U6.8 (V+), U8.8 (VCC), U10.2 (VOUT), U10.4 (VOUT), U13.1 (V+), U27.1 (IOVDD), U27.10 (IOVDD), U27.22 (IOVDD), U27.33 (IOVDD), U27.42 (IOVDD), U27.43 (ADC_AVDD), U27.44 (VREG_IN), U27.48 (USB_VDD), U27.49 (IOVDD); also elsewhere on the board
/3V6: R21.1; also elsewhere on the board
/5V: C90.1, D5.1 (A1), J6.A4B9 (VBUS), J6.B4A9 (VBUS), J20.1, U9.2 (VDD), U10.3 (VIN); also elsewhere on the board
/Data/1V1: C100.2, C101.2, C102.2, U27.23 (DVDD), U27.45 (VREG_VOUT), U27.50 (DVDD)
/Data/GPIO25: J20.6, U27.37 (GPIO25)
/Data/GPIO26: J20.5, U27.39 (GPIO27_ADC1)
/Data/GPIO27: J20.4, U27.40 (GPIO28_ADC2)
/Data/GPIO28: J20.3, U27.41 (GPIO29_ADC3)
/Data/PWR_EN: U27.2 (GPIO0); also elsewhere on the board
/Data/QSPI_SCLK: U8.6 (CLK), U27.52 (QSPI_SCLK)
/Data/QSPI_SD0: U8.5 (DI(IO0)), U27.53 (QSPI_SD0)
/Data/QSPI_SD1: U8.2 (DO(IO1)), U27.55 (QSPI_SD1)
/Data/QSPI_SD2: U8.3 (/WP(IO2)), U27.54 (QSPI_SD2)
/Data/QSPI_SD3: U8.7 (/HOLDOR/RESET(IO3)), U27.51 (QSPI_SD3)
/Data/QSPI_SS: R50.2, R55.1, U8.1 (/CS), U27.56 (QSPI_SS)
/Data/SCL: R20.1, TP1.1, U6.2 (SCL), U13.8 (SCL), U27.18 (GPIO15); also elsewhere on the board
/Data/SDA: R19.2, TP2.1, U6.1 (SDA), U13.7 (SDA), U27.17 (GPIO14); also elsewhere on the board
/Data/SWCLK: J6.A8 (SBU1), U27.24 (SWCLK)
/Data/SWD: J6.B8 (SBU2), U27.25 (SWD)
/Data/THERM: R35.2, U13.4 (THERM), U27.4 (GPIO2)
/Data/USB_DN: J6.A7 (D-), J6.B7 (D-), R54.1, U12.1 (I/O)
/Data/USB_DP: J6.A6 (D+), J6.B6 (D+), R53.1, U11.1 (I/O)
/Data/VDD_SENSE: R21.2, R22.1, U27.38 (GPIO26_ADC0)
/Data/XIN: C97.2, U27.20 (XIN), Y1.3
/Data/XOUT: C96.2, U27.21 (XOUT), Y1.1
/RST: U27.14 (GPIO11); also elsewhere on the board
/RX: U27.12 (GPIO9); also elsewhere on the board
/TEMP_N: R70.1; also elsewhere on the board
/TEMP_P: R61.1; also elsewhere on the board
/TX: U27.11 (GPIO8); also elsewhere on the board
GND: C24.2, C32.2, C90.2, C96.1, C97.1, C98.2, C99.1, C100.1, C101.1, C102.1, C103.1, C104.1, C105.1, C106.1, C107.1, C108.1, C109.1, C110.1, D5.2 (A2), J6.A1B12 (GND), J6.B1A12 (GND), J6.S1 (SHIELD), J20.2, R22.2, R51.1, R52.1, SW1.2, SW2.2, TP3.1, U6.4 (GND), U6.5 (A2), U6.7 (A0), U8.4 (GND), U8.9 (EPAD), U9.4 (GND), U10.1 (GND), U11.2 (GND), U12.2 (GND), U13.5 (GND), U27.19 (TESTEN), U27.57 (GND), Y1.2, Y1.4; also elsewhere on the board
unnamed: J6.A5 (CC1), R51.2
unnamed: J6.B5 (CC2), R52.2
unnamed: R55.2, SW1.1
unnamed: C33.1, R61.2, U13.2 (D+)
unnamed: C33.2, R70.2, U13.3 (D-)
unnamed: U9.1 (DIN), U27.3 (GPIO1)
unnamed: R34.1, SW2.1, U27.26 (RUN)
unnamed: R54.2, U27.46 (USB_DM)
unnamed: R53.2, U27.47 (USB_DP)

Notes on the sheet:
BOOT
Accessory Port
I2C Address: 0x4A
Temperature Sensors
I2C Address: 0x49
RESET

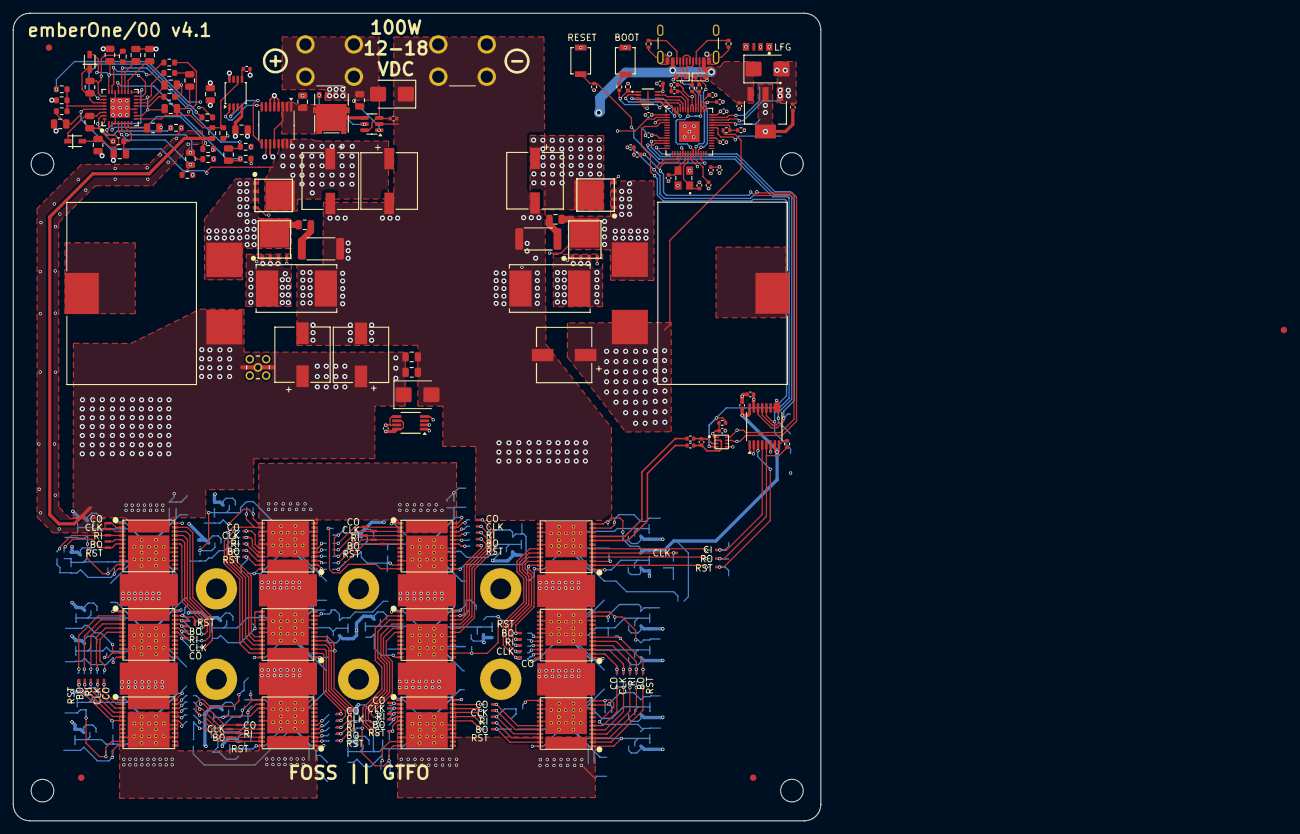
[picture p8: board emberone.kicad_pcb from above]

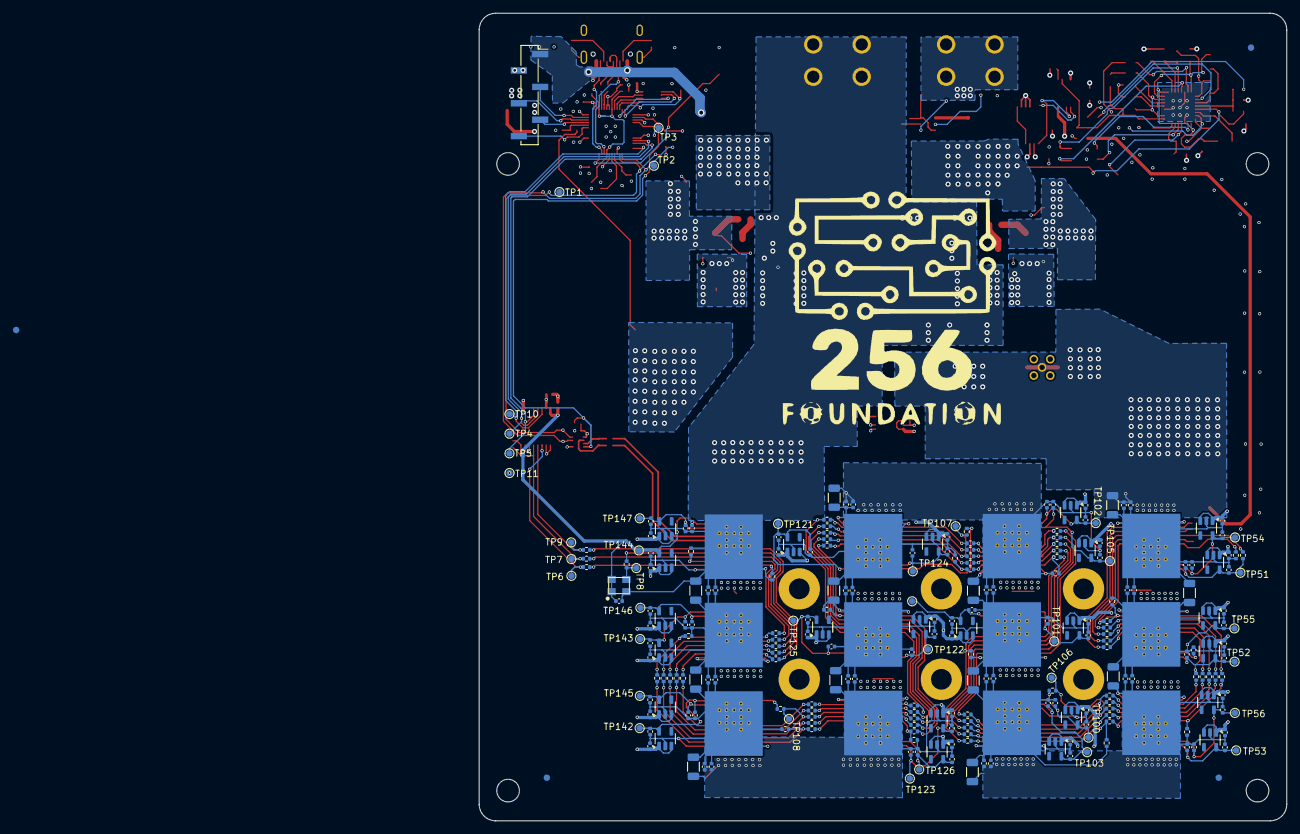
[picture p9: board emberone.kicad_pcb from below]

Board: 6 copper layers, 125.0 x 125.0 mm, 468 parts (250 on the bottom side), 239 nets.
